BARDAK1995/me407/docs/figures/mid_frame_render.png

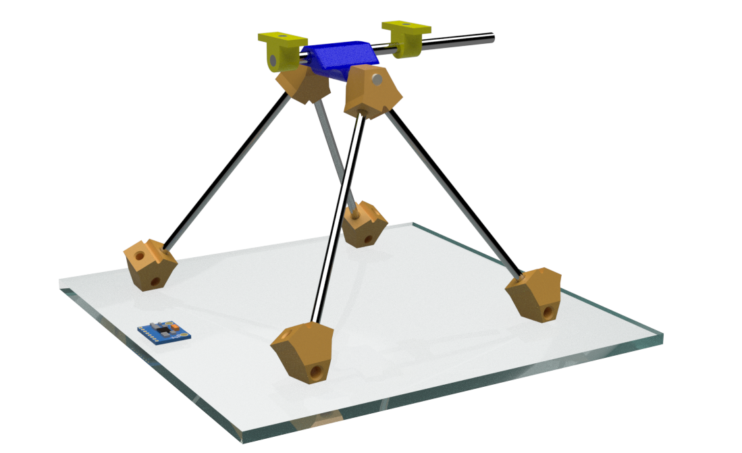
docs/figures/mid_frame_render.png
