BARDAK1995/me407/hardware/BOM.xlsx

Descriptive Part Name | Count | Malzeme Maliyet listesi |  |  |  |  | 3D Printed parts |  |  |  |  | Machined PARTS | operations | machiningTime | unitCost(tl/h) | cost
mpu6050 | 2 | mpu6050 | 2 | 10 | 20 | TL | MPU_ArkaBlokprt x 2 | 2 |  |  |  | tablaCNCfixture | drilling&Milling | 2h | 25 | 50
MPU_ArkaBlokprt x 2 | 2 | 8_digit_7_segment v7 v1_step | 1 | 12 | 12 | TL | mentese | 1 |  |  |  | Tabla | drilling&Milling | 1h | 25 | 25
8_digit_7_segment v7 v1_step | 1 | 4mm_shaft | 1 | 1.666666667 | 1.666666667 | TL | 4mmShaft_fixer x 2 | 2 |  |  |  | plexyBase | drilling&Milling | 0.5h | 25 | 12.5
mentese | 1 | plexyBase | 1 | 18 | 18 | TL | 4mmShaft_fixer_Rev2 x 2 | 2 |  |  |  | plexyBase_alt | drilling | 6min | 25 | 2.5
4mm_shaft | 1 | 4mm_shaft_50mm | 1 | 0.75 | 0.75 | TL | Alt_pim_ADAPTOR | 2 |  |  |  |  |  |  |  | 90
4mmShaft_fixer x 2 | 2 | 4mm_shaft_100mm | 4 | 1.5 | 6 | TL | Alt_pim_ADAPTOR_mirror | 2
4mmShaft_fixer_Rev2 x 2 | 2 | 35mm_cekmePimi | 4 | 1.5 | 6 | TL | yeni_taban_MIRROR | 2
plexyBase | 1 | coupling8_5 | 2 | 11 | 22 | TL | yeni_taban | 2
4mm_shaft_50mm | 1 | TrapexMil | 2 | 20 | 40 | TL | motorShaftHolder | 2
4mm_shaft_100mm | 4 | 4mm_shaft_80mm | 2 | 1.25 | 2.5 | TL | TrapexMilSOMUN | 2
Alt_pim_ADAPTOR | 2 | NEMA_17_STEPPER_34mm | 2 | 65 | 130 | TL | base_Kose_parca | 4
Alt_pim_ADAPTOR_mirror | 2 | plexyBase_Alt | 1 | 10 | 10 | TL | sliderTutucu | 2
35mm_cekmePimi | 4 | pcbKart_8x6 | 2 | 4 | 8 | TL | baglantiMillerArasiUst | 2
yeni_taban_MIRROR | 2 | pcbKart_3x7 | 1 | 3 | 3 | TL | GT2_80Tooth_customPulley | 1
yeni_taban | 2 | pcbKart_2x8 | 1 | 2.5 | 2.5 | TL | nema11_ust_adaptor | 1
motorAssembly | 2 | POS5 MAFSAL | 2 | 10 | 20 | TL
coupling8_5 | 2 | A4988 RED_stepper driver | 3 | 9 | 27 | TL | TOTAL PRINT TIME | 6 | h
TrapexMil | 2 | ATMega328 | 4 | 20 | 80 | TL | COST | 12 | TL
motorShaftHolder | 2 | tabla | 1 | 4 | 4 | TL
4mm_shaft_80mm | 2 | tablaCNCfixture 200x200x30 ahsap | 1 | 20 | 20 | TL
TrapexMilSOMUN | 2 | Shf 8 | 1 | 20 | 20 | TL
NEMA_17_STEPPER_34mm | 2 | 4mm_shaft_USTRAY | 1 | 1.5 | 1.5 | TL
plexyBase_Alt | 1 | 4mm_shaft_110 | 2 | 1.666666667 | 3.333333333 | TL
base_Kose_parca | 3 | GT2_16 Teeth Pulley. | 1 | 10 | 10 | TL
pcbKart_8x6 | 2 | 8MM_ust_MIL | 1 | 3 | 3 | TL
pcbKart_3x7 | 1 | NEMA11_stepper | 1 | 140 | 140 | TL | Tasarim maliyeti
pcbKart_2x8 | 1 | RULMAN_ic_custom | 2 | 10 | 20 | TL | Tanim | iscilik saati | birim maliyet | TOPLAM MALIYET
POS5 MAFSAL | 2 | GT2_200mm_kapaliKayis | 1 | 12 | 12 | TL | Mekanik Tasarim isciligi | 150 | 35 | 5250 | TL
A4988 RED_stepper driver | 3 | Hex Nut, 1A, DIN,M4x0_7 316 | 6 | 0.04 | 0.24 | TL | elektronik&yazilim tasarimi | 100 | 35 | 3500 | TL
ATMega328 | 4 | DISPLAY_SUBBASS | 1 |  | 0 | TL | Testler dizayni calismalari | 5 | 35 | 175 | TL
topAssemblyprt | 1 | Hex Socket C-sunk Head Screw, DIN,M4x16 | 24 | 0.3 | 7.2 | TL | gelistirme testleri | 5 | 35 | 175 | TL
tablaCNCfixture 200x200x30 ahsap |  | Hex Socket Head Cap Screw, AM,M3x0.5x8 | 24 | 0.5 | 12 | TL | teknik resimler | 2 | 35 | 70 | TL
tabla | 1 | Hex Nut, 1A, DIN,M3x0_5 | 29 | 0.36 | 10.44 | TL |  |  |  | 9170 | TL
Shf 8 | 1 | Hex Socket Head Cap Screw, AM,M2.5x0.5x10 | 4 | 2 | 8 | TL | Kalite Maliyeti
sliderTutucu | 2 | 4digit 7 segment display module | 1 | 14 | 14 | TL | Tanim | iscilik saati | birim maliyet | TOPLAM MALIYET
4mm_shaft_USTRAY | 1 | on/OFF switch | 1 | 1.5 | 1.5 | TL | Millerin cap olcumu/fit testleri | 1 | 35 | 35 | TL
baglantiMillerArasiUst | 2 | nrf24l01 | 2 | 8 | 16 | TL | uretilen parcalarin mastarla testi | 1 | 35 | 35 | TL
4mm_shaft_110 | 2 | Arduino Nano | 1 | 24 | 24 | TL | Gereksinim dogrulama testleri | 10 | 35 | 350 | TL
GT2_16 Teeth Pulley. | 1 | 3.7v lithium Battery | 1 | 24 | 24 | TL |  |  |  | 420 | TL
8MM_ust_MIL | 1 | step up convertor | 1 | 6 | 6 | TL | Montaj Isciligi Maliyeti
GT2_80Tooth_customPulley | 1 | Joystick module | 1 | 3 | 3 | TL | Tanim | iscilik saati | birim maliyet | TOPLAM MALIYET
NEMA11_stepper | 1 | 2.1mm DC female Jack | 1 | 2 | 2 | TL | Montaj calismalari | 1 | 35 | 35 | TL
RULMAN_ic_custom | 2 | 3.3v Stepdown regulator | 1 | 2.5 | 2.5 | TL | elektronik kart dizimi | 5 | 35 | 175 | TL
nema11_ust_adaptor | 1 | 5v Stepdown regulator | 1 | 3 | 3 | TL |  |  |  | 210 | TL
GT2_200mm_kapaliKayis | 1 | big fin | 1 | 2 | 2 | TL | Montaj Isciligi Maliyeti
Hex Nut, 1A, DIN,M4x0_7 316 | 6 | small fin | 4 | 1.2 | 4.8 | TL | Tanim | iscilik saati | birim maliyet | TOPLAM MALIYET
DISPLAY_SUBBASS | 1 | 2.2uF elektrolit CAP | 4 | 1.25 | 5 | TL | Montaj calismalari | 1 | 35 | 35 | TL
Hex Socket C-sunk Head Screw, DIN,M4x16 | 24 | 1000UF elektrolit cap | 1 | 0.65 | 0.65 | TL | elektronik kart dizimi | 5 | 35 | 175 | TL
Hex Socket Head Cap Screw, AM,M3x0.5x8 | 24 | 22nf ceramic cap | 8 | 1 | 8 | TL |  |  |  | 210 | TL
Hex Nut, 1A, DIN,M3x0_5 | 29 | 16mgz quarts cristal oscilator | 4 | 1 | 4 | TL | Uretici yatirim maliyetleri
Hex Socket Head Cap Screw, AM,M2.5x0.5x10 | 4 | male header | 35 | 0.1 | 3.5 | TL | CNC |  |  | 1800 | TL
 |  | female header | 150 | 0.1 | 15 | TL | CNC Enclosure/Isolation |  |  | 450 | TL
4digit 7 segment display module | 1 | 2pin cable | 2 | 1 | 2 | TL | CNC milling/Drilling bits |  |  | 350 | TL
on/OFF switch | 1 | 3 pin cable | 2 | 2 | 4 | TL |  |  |  | 2600 | TL
nrf24l01 | 2 | 5pin cable | 4 | 6 | 24 | TL
Arduino Nano | 1 | 12v 1.5amp DC POWER SUPLY | 1 | 15 | 15 | TL
3.7v lithium Battery | 1 | TOTAL COST |  |  | 865.08 | TL
step up convertor | 1
Joystick module | 1
2.1mm DC female Jack | 1
3.3v Stepdown regulator | 1
5v Stepdown regulator | 1
big fin | 1
small fin | 4
2.2uF elektrolit CAP | 4
1000UF elektrolit cap | 1
22nf ceramic cap | 8
16mgz quarts cristal oscilator | 4
male header | 35
female header | 150
2pin cable | 2
3 pin cable | 2
5pin cable | 4
12v 1.5amp DC POWER SUPLY | 1
