BARDAK1995/me407/hardware/cost.xlsx

COST&PROJECT BUDGET
Component costs
Description | ### | Unit Cost | Total Cost
mpu6050 | 2 | 10.0 | 20 | TL
8_digit_7_segment v7 | 1 | 12.0 | 12 | TL
4mm_shaft | 1 | 1.7 | 1.666666667 | TL
plexyBase | 1 | 15.0 | 15 | TL
4mm_shaft_50mm | 1 | 0.8 | 0.75 | TL
4mm_shaft_100mm | 4 | 1.5 | 6 | TL
35mm_cekmePimi | 4 | 1.5 | 6 | TL | Tasarim maliyeti
coupling8_5 | 2 | 11.0 | 22 | TL | Tanim | iscilik saati | birim maliyet | TOPLAM MALIYET
TrapexMil | 2 | 20.0 | 40 | TL | Mekanik Tasarim isciligi | 150 | 35 | 5250 | TL
4mm_shaft_80mm | 2 | 1.2 | 2.5 | TL | elektronik&yazilim tasarimi | 100 | 35 | 3500 | TL
NEMA_17_STEPPER_34mm | 2 | 65.0 | 130 | TL | Testler dizayni calismalari | 5 | 35 | 175 | TL
plexyBase_Alt | 1 | 10.0 | 10 | TL | gelistirme testleri | 5 | 35 | 175 | TL
pcbKart_8x6 | 2 | 4.0 | 8 | TL | teknik resimler | 2 | 35 | 70 | TL
pcbKart_3x7 | 1 | 3.0 | 3 | TL |  |  |  | 9170 | TL
pcbKart_2x8 | 1 | 2.5 | 2.5 | TL | Kalite Maliyeti
POS5 MAFSAL | 2 | 10.0 | 20 | TL | Tanim | iscilik saati | birim maliyet | TOPLAM MALIYET
A4988 RED_stepper driver | 3 | 9.0 | 27 | TL | Millerin cap olcumu/fit testleri | 1 | 35 | 35 | TL
ATMega328 | 4 | 20.0 | 80 | TL | uretilen parcalarin mastarla testi | 1 | 35 | 35 | TL
tabla | 1 | 4.0 | 4 | TL | Gereksinim dogrulama testleri | 10 | 35 | 350 | TL
tablaCNCfixture 200x200x30 ahsap | 1 | 20.0 | 20 | TL |  |  |  | 420 | TL
Shf 8 | 1 | 20.0 | 20 | TL | Montaj Isciligi Maliyeti
4mm_shaft_USTRAY | 1 | 1.5 | 1.5 | TL | Tanim | iscilik saati | birim maliyet | TOPLAM MALIYET
4mm_shaft_110 | 2 | 1.7 | 3.333333333 | TL | Montaj calismalari | 1 | 35 | 35 | TL
GT2_16 Teeth Pulley. | 1 | 10.0 | 10 | TL | elektronik kart dizimi | 5 | 35 | 175 | TL
8MM_ust_MIL | 1 | 3.0 | 3 | TL |  |  |  | 210 | TL
NEMA11_stepper | 1 | 140.0 | 140 | TL | Montaj Isciligi Maliyeti
RULMAN_ic_custom | 2 | 10.0 | 20 | TL | Tanim | iscilik saati | birim maliyet | TOPLAM MALIYET
GT2_200mm_kapaliKayis | 1 | 12.0 | 12 | TL | Montaj calismalari | 1 | 35 | 35 | TL
Hex Nut, 1A, DIN,M4x0_7 316 | 6 | 0.04 | 0.24 | TL | elektronik kart dizimi | 5 | 35 | 175 | TL
DISPLAY_SUBBASS | 1 |  | 0 | TL |  |  |  | 210 | TL
Hex Socket C-sunk Head Screw, DIN,M4x16 | 24 | 0.3 | 7.2 | TL | Uretici yatirim maliyetleri
Hex Socket Head Cap Screw, AM,M3x0.5x8 | 24 | 0.5 | 12 | TL | CNC |  |  | 1800 | TL
Hex Nut, 1A, DIN,M3x0_5 | 29 | 0.4 | 10.44 | TL | CNC Enclosure/Isolation |  |  | 450 | TL
Hex Socket Head Cap Screw, AM,M2.5x0.5x10 | 4 | 2.0 | 8 | TL | CNC milling/Drilling bits |  |  | 350 | TL
4digit 7 segment display module | 1 | 14.0 | 14 | TL |  |  |  | 2600 | TL
on/OFF switch | 1 | 1.5 | 1.5 | TL
nrf24l01 | 2 | 8.0 | 16 | TL
Arduino Nano | 1 | 24.0 | 24 | TL
3.7v lithium Battery | 1 | 24.0 | 24 | TL
step up convertor | 1 | 6.0 | 6 | TL
Joystick module | 1 | 3.0 | 3 | TL
2.1mm DC female Jack | 1 | 2.0 | 2 | TL
3.3v Stepdown regulator | 1 | 2.5 | 2.5 | TL
5v Stepdown regulator | 1 | 3.0 | 3 | TL
big fin | 1 | 2.0 | 2 | TL
small fin | 4 | 1.2 | 4.8 | TL
2.2uF elektrolit CAP | 4 | 1.2 | 5 | TL
1000UF elektrolit cap | 1 | 0.7 | 0.65 | TL
22nf ceramic cap | 8 | 1.0 | 8 | TL
16mgz quarts cristal oscilator | 4 | 1.0 | 4 | TL
male header | 35 | 0.1 | 3.5 | TL
female header | 150 | 0.1 | 15 | TL
2pin cable | 2 | 1.0 | 2 | TL
3 pin cable | 2 | 2.0 | 4 | TL
5pin cable | 4 | 6.0 | 24 | TL
12v 1.5amp DC POWER SUPLY | 1 | 15.0 | 15 | TL
TOTAL COST |  |  | 862.08 | TL
3D Printed parts
Part Name |  |  | # of items
MPU_ArkaBlokprt x 2 |  |  | 2
mentese |  |  | 1
4mmShaft_fixer x 2 |  |  | 2
4mmShaft_fixer_Rev2 x 2 |  |  | 2
Alt_pim_ADAPTOR |  |  | 2
Alt_pim_ADAPTOR_mirror |  |  | 2
yeni_taban_MIRROR |  |  | 2
yeni_taban |  |  | 2
motorShaftHolder |  |  | 2
TrapexMilSOMUN |  |  | 2
base_Kose_parca |  |  | 4
sliderTutucu |  |  | 2
baglantiMillerArasiUst |  |  | 2
GT2_80Tooth_customPulley |  |  | 1
nema11_ust_adaptor |  |  | 1
TOTAL PRINT TIME |  |  | 6 | h
TOTAL COST |  |  | 12 | TL
MACHINED PARTS
Part Name | operations | machiningTime | unitCost(tl/h) | cost
tablaCNCfixture | drilling&Milling | 2h | 25 | 50
Tabla | drilling&Milling | 1h | 25 | 25
plexyBase | drilling&Milling | 0.5h | 25 | 12.5
plexyBase_alt | drilling | 6min | 25 | 2.5
TOTAL COST |  |  | 90 | TL
Design&development Costs
Description | man hours | Cost/time | TOTAL COST
mechanical design | 150 | 35 | 5250 | TL
Electronics&software design | 100 | 35 | 3500 | TL
Test design | 5 | 35 | 175 | TL
Project development tests | 5 | 35 | 175 | TL
Technical drawings | 2 | 35 | 70 | TL
TOTAL COST |  |  | 9170 | TL
quality management costs
Description | man hours | Cost/time | TOTAL COST
dimensional testing of the parts&fits | 1 | 35 | 35 | TL
Qualification tests | 10 | 35 | 350 | TL
TOTAL COST |  |  | 385 | TL
Assembly Costs
Description | man hours | Cost/time | TOTAL COST
Mechanical assembly | 1 | 35 | 35 | TL
Circuit Soldering&testing | 5 | 35 | 175 | TL
TOTAL COST |  |  | 210 | TL
Manufacturer investment costs
CNC router build+mods |  |  | 2000 | TL
CNC Enclosure/Isolation |  |  | 350 | TL
CNC milling/Drilling bits |  |  | 350 | TL
SOLDERING STATION&HEAT GUN |  |  | 800 | TL
TOTAL COST |  |  | 3500 | TL
Total cost without Labor |  |  | 4374.08 | TL
TOTAL Labor Cost |  |  | 9855 | TL
TOTAL COST |  |  | 14229.08 | TL
