BARDAK1995/me407/hardware/step/8MM_ust_MIL.stp

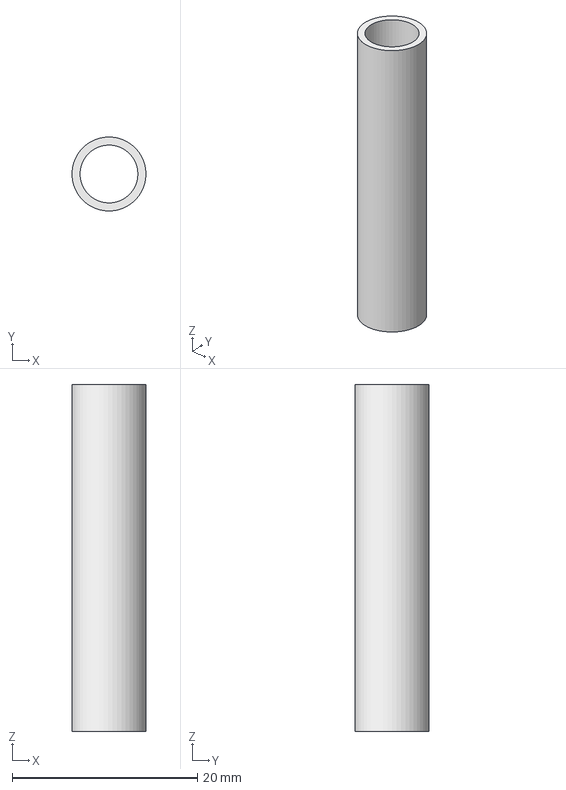
[picture p11: CAD file, 2026-10-28]
hardware/step/8MM_ust_MIL.stp
7.99 x 8.00 x 37.5 mm
