BARDAK1995/me407/hardware/step/4mm_shaft_110.stp

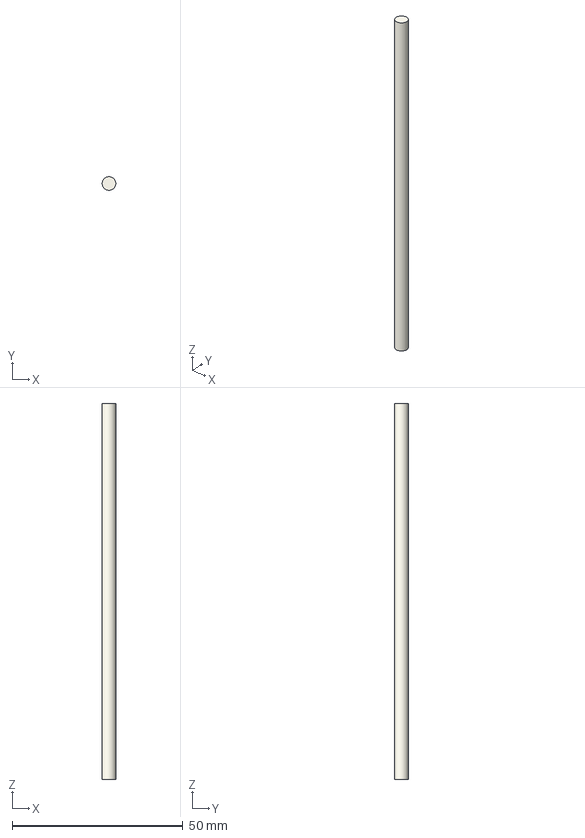
[picture p12: CAD file, 2026-10-28]
hardware/step/4mm_shaft_110.stp
4.00 x 4.00 x 110.0 mm
