BARDAK1995/me407/hardware/step/4mmShaft_fixer_Rev2.stp

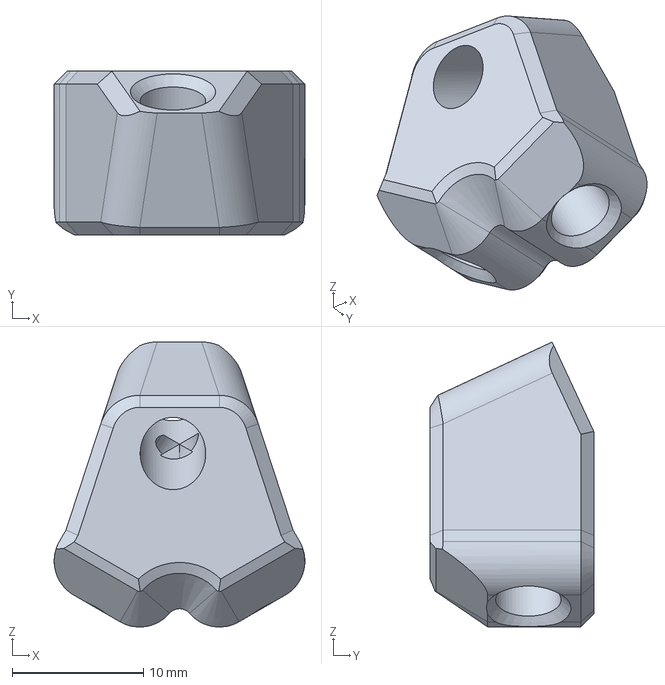
[picture p13: CAD file, 2026-10-28]
hardware/step/4mmShaft_fixer_Rev2.stp
19.1 x 12.5 x 21.7 mm
