BARDAK1995/me407/hardware/step/4mm_shaft_2.stp

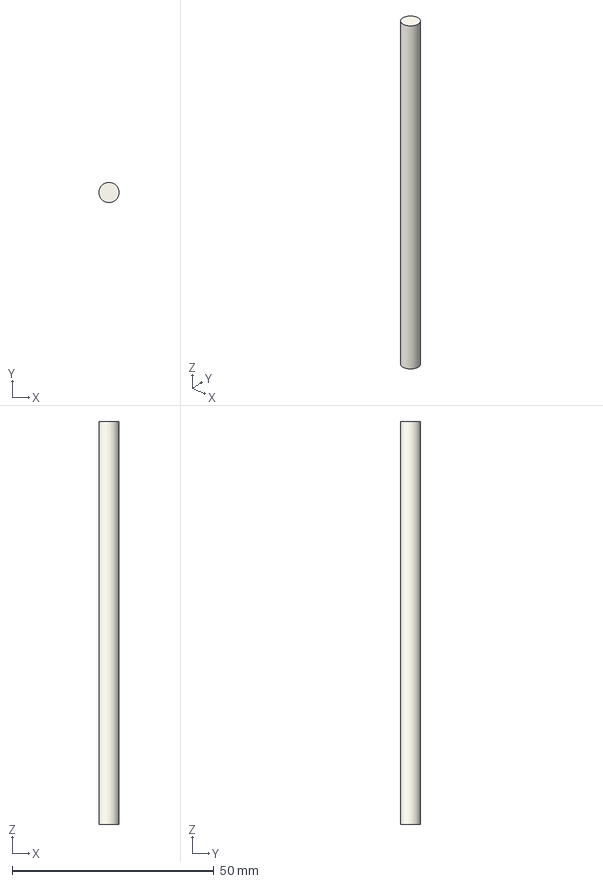
[picture p14: CAD file, 2026-10-28]
hardware/step/4mm_shaft_2.stp
5.00 x 5.00 x 100.0 mm
