BARDAK1995/me407/hardware/step/tabla.stp

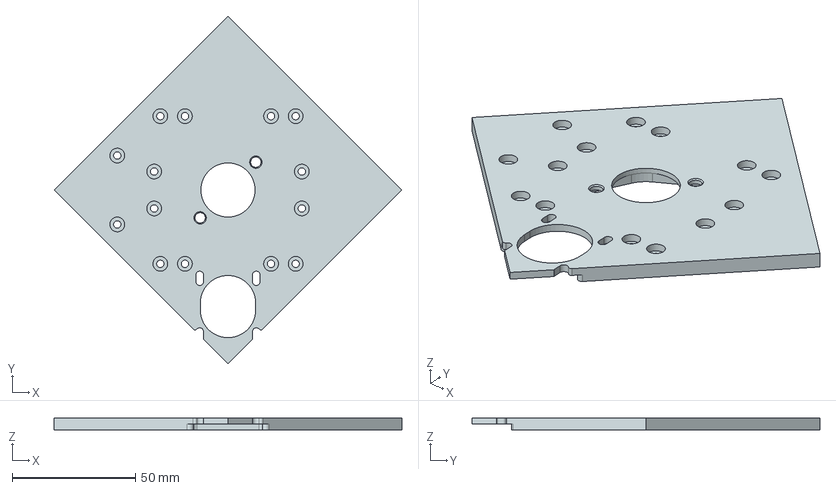
[picture p15: CAD file, 2026-10-28]
hardware/step/tabla.stp
141.4 x 141.4 x 5.00 mm
