BARDAK1995/me407/hardware/step/yeni_taban.stp

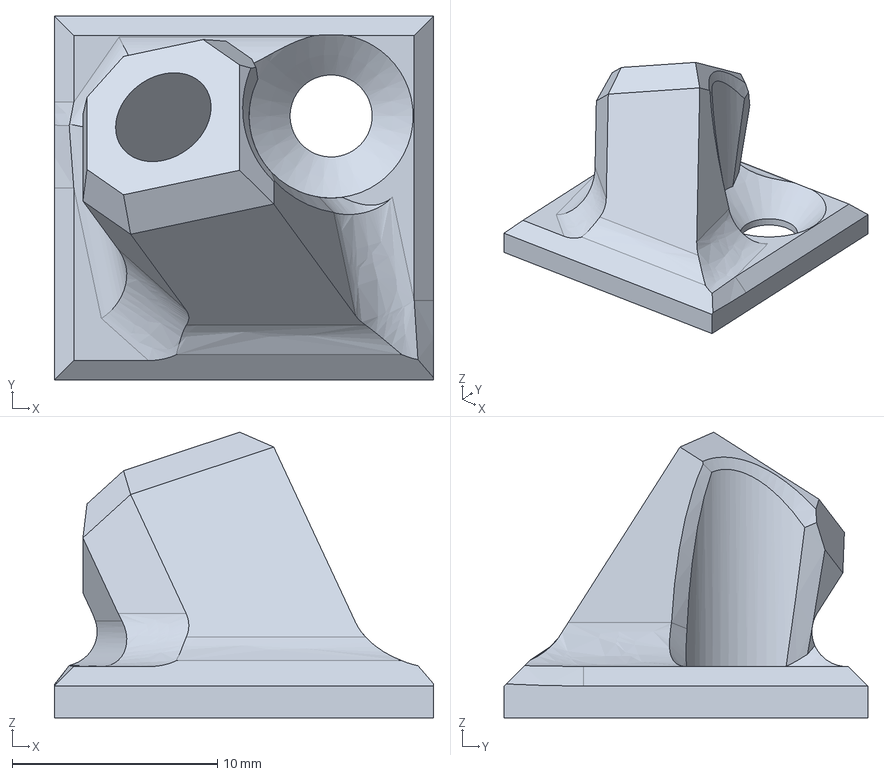
[picture p16: CAD file, 2026-10-28]
hardware/step/yeni_taban.stp
18.5 x 17.8 x 13.9 mm
