BARDAK1995/me407/hardware/step/MPU_ArkaBlokprt.stp

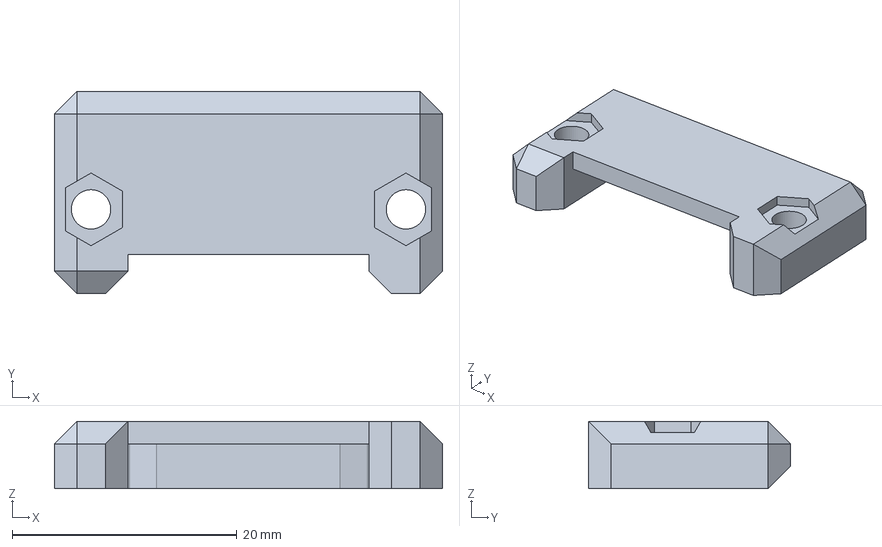
[picture p17: CAD file, 2026-10-28]
hardware/step/MPU_ArkaBlokprt.stp
34.5 x 18.0 x 6.00 mm
