BARDAK1995/me407/hardware/step/Alt_pim_ADAPTOR.stp

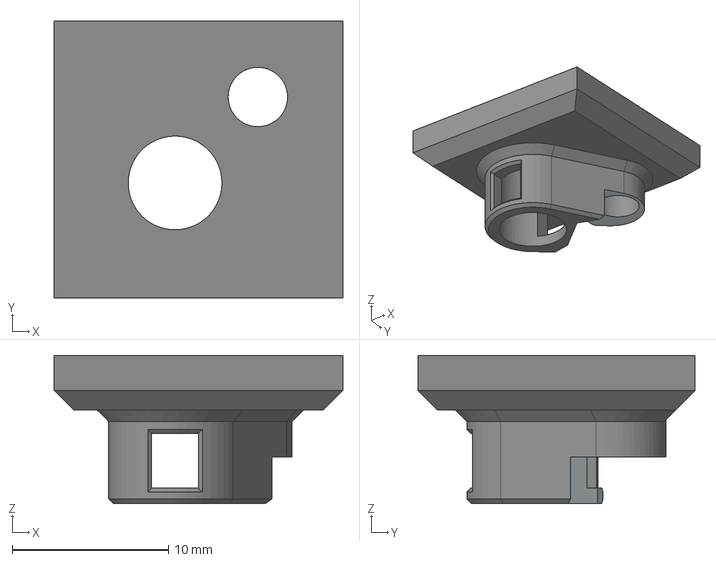
[picture p18: CAD file, 2026-10-28]
hardware/step/Alt_pim_ADAPTOR.stp
18.5 x 17.8 x 9.50 mm
