BARDAK1995/me407/hardware/step/35mm_cekmePimi.stp

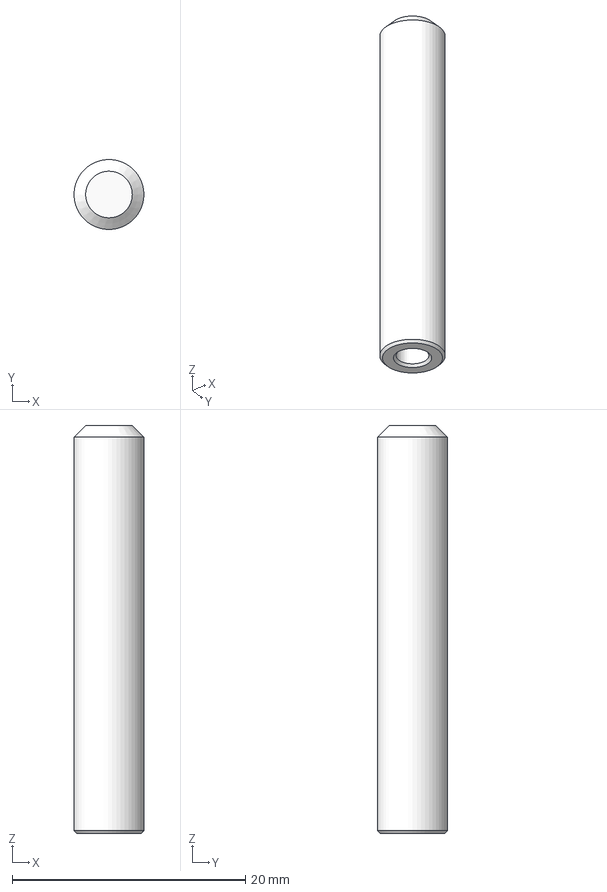
[picture p19: CAD file, 2026-10-28]
hardware/step/35mm_cekmePimi.stp
5.99 x 6.00 x 35.0 mm
