BARDAK1995/me407/hardware/step/sliderTutucu.stp

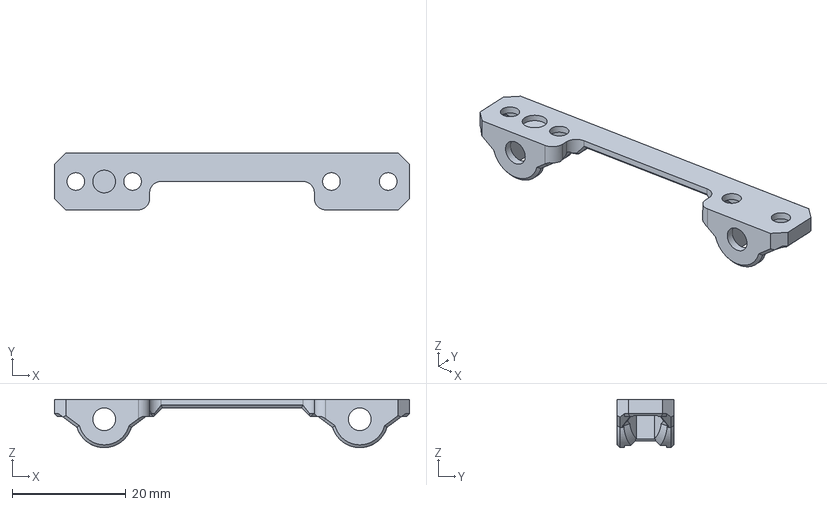
[picture p20: CAD file, 2026-10-28]
hardware/step/sliderTutucu.stp
62.5 x 10.0 x 8.49 mm
