BARDAK1995/me407/hardware/step/baglantiMillerArasiUst.stp

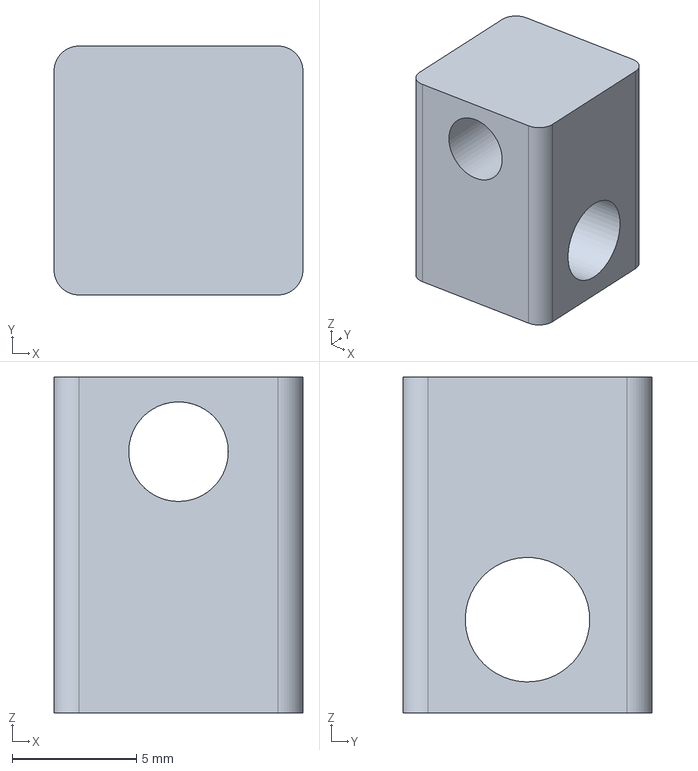
[picture p21: CAD file, 2026-10-28]
hardware/step/baglantiMillerArasiUst.stp
10.0 x 10.0 x 13.5 mm
