BARDAK1995/me407/hardware/step/POS5Holder.stp

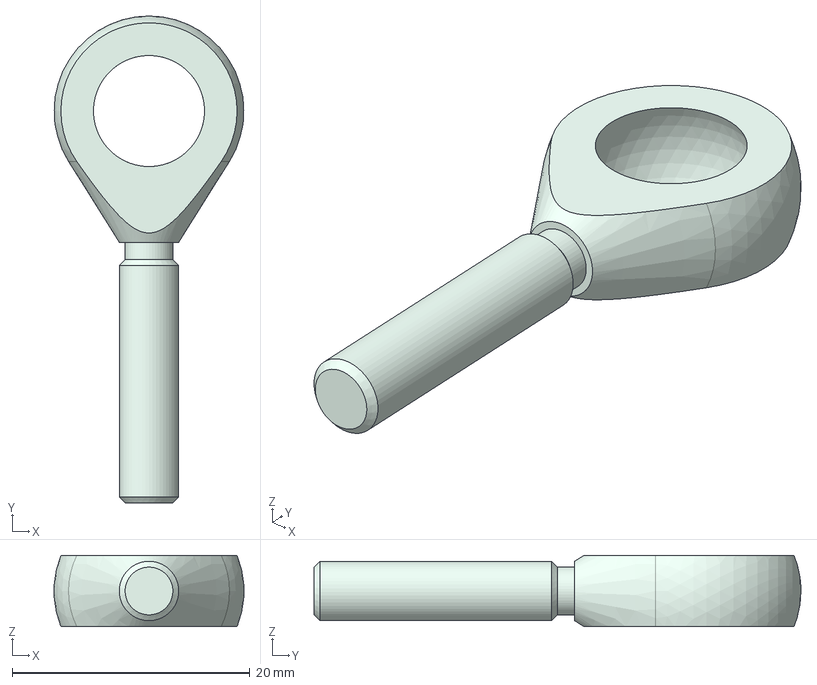
[picture p22: CAD file, 2026-10-28]
hardware/step/POS5Holder.stp
16.0 x 41.0 x 6.00 mm
