BARDAK1995/me407/hardware/step/motorShaftHolder.stp

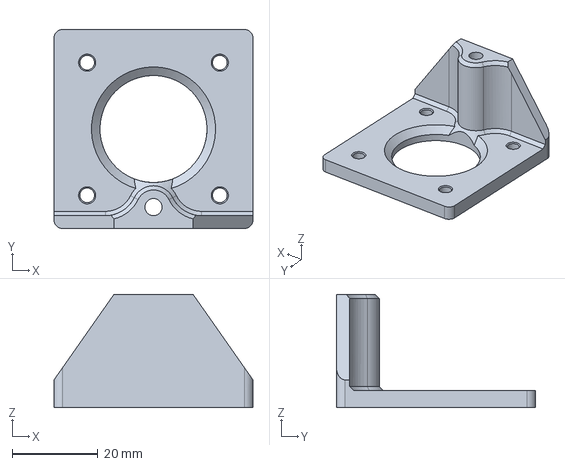
[picture p23: CAD file, 2026-10-28]
hardware/step/motorShaftHolder.stp
46.5 x 46.5 x 26.5 mm
