BARDAK1995/me407/hardware/step/Alt_pim_ADAPTOR_mirror2.stp

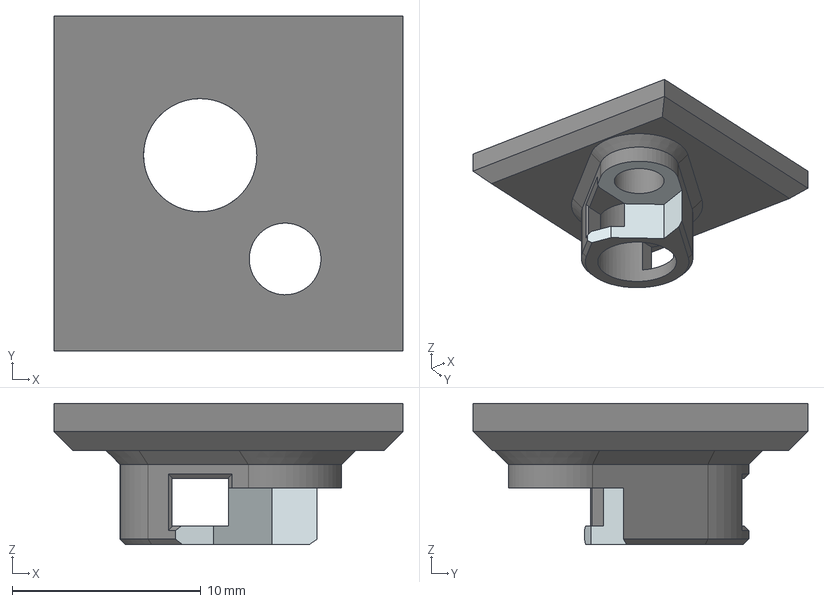
[picture p24: CAD file, 2026-10-28]
hardware/step/Alt_pim_ADAPTOR_mirror2.stp
18.5 x 17.8 x 7.50 mm
