BARDAK1995/me407/hardware/step/mentese.stp

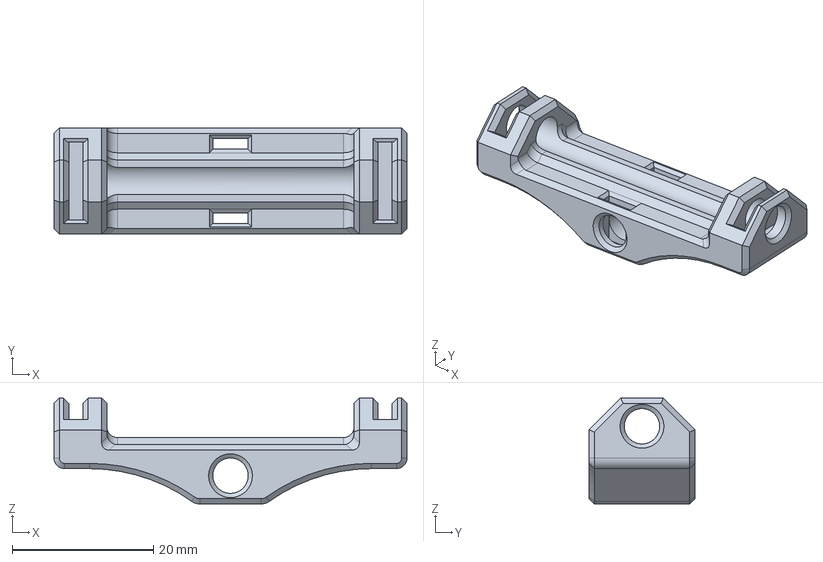
[picture p25: CAD file, 2026-10-28]
hardware/step/mentese.stp
50.0 x 15.0 x 15.0 mm
