BARDAK1995/me407/hardware/step/200Kayis.stp

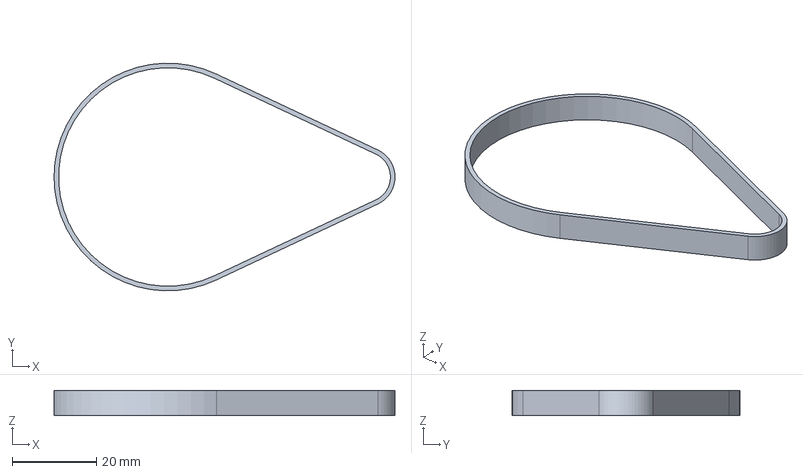
[picture p26: CAD file, 2026-10-28]
hardware/step/200Kayis.stp
81.2 x 54.2 x 6.00 mm
