BARDAK1995/me407/hardware/step/fan_adaptor.stp

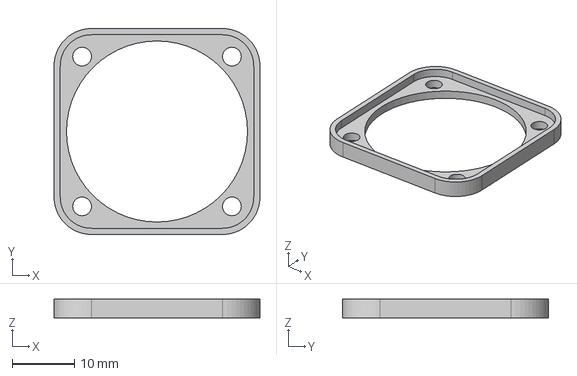
[picture p27: CAD file, 2026-10-28]
hardware/step/fan_adaptor.stp
33.0 x 33.0 x 3.00 mm
