BARDAK1995/me407/hardware/step/plexyBase_Alt.stp

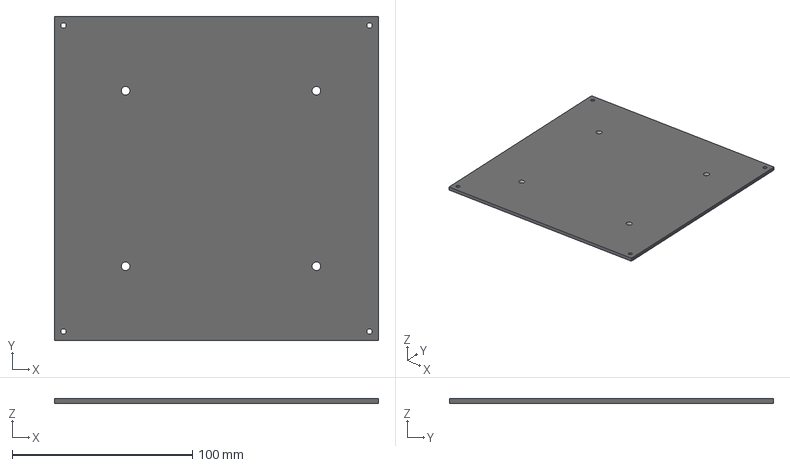
[picture p28: CAD file, 2026-10-28]
hardware/step/plexyBase_Alt.stp
180.0 x 180.0 x 2.70 mm
