BARDAK1995/me407/hardware/step/4mm_shaft_USTRAY.stp

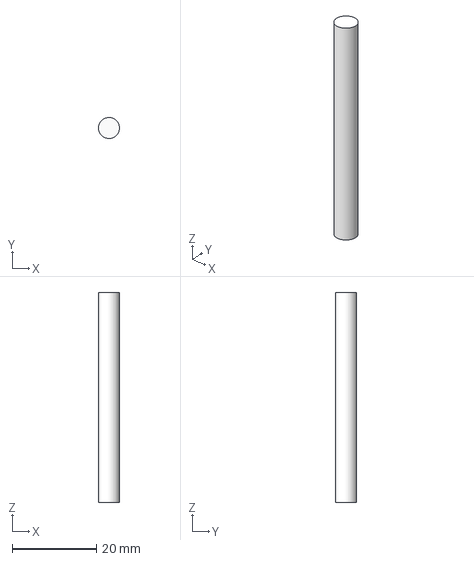
[picture p29: CAD file, 2026-10-28]
hardware/step/4mm_shaft_USTRAY.stp
5.00 x 5.00 x 50.0 mm
