BARDAK1995/me407/hardware/step/POS5Spherical_inner_ring.stp

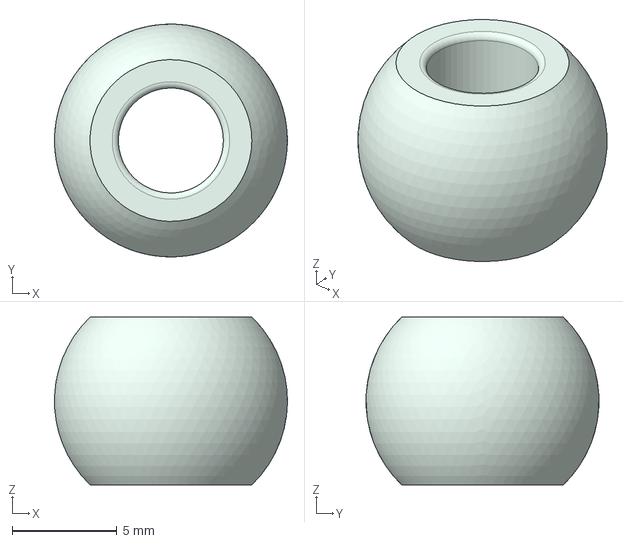
[picture p30: CAD file, 2026-10-28]
hardware/step/POS5Spherical_inner_ring.stp
11.1 x 11.1 x 8.00 mm
