BARDAK1995/me407/hardware/step/RULMAN_ic_custom.stp

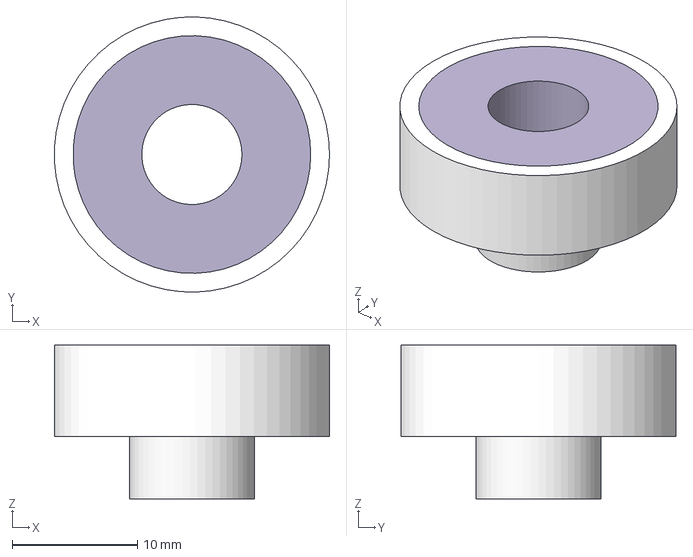
[picture p31: CAD file, 2026-10-28]
hardware/step/RULMAN_ic_custom.stp
22.0 x 22.0 x 12.3 mm
