BARDAK1995/me407/hardware/step/nema11_ust_adaptor.stp

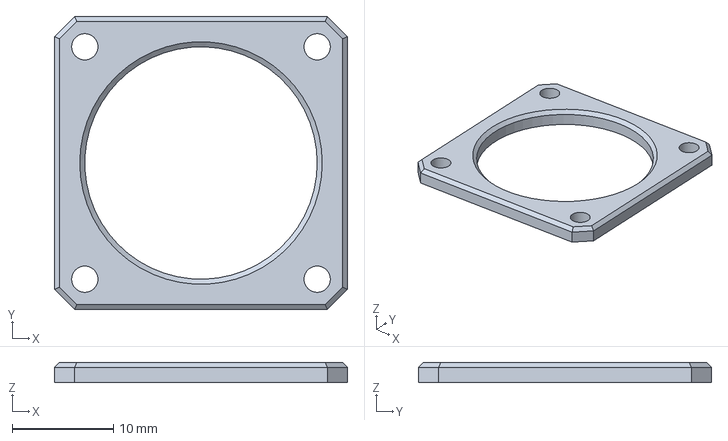
[picture p32: CAD file, 2026-10-28]
hardware/step/nema11_ust_adaptor.stp
29.0 x 29.0 x 2.00 mm
