BARDAK1995/me407/hardware/step/plexyBase.stp

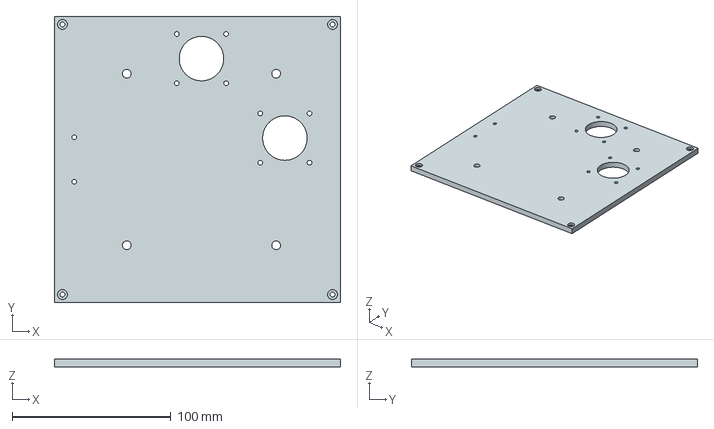
[picture p33: CAD file, 2026-10-28]
hardware/step/plexyBase.stp
180.0 x 180.0 x 5.00 mm
