BARDAK1995/me407/hardware/step/base_Kose_parca.stp

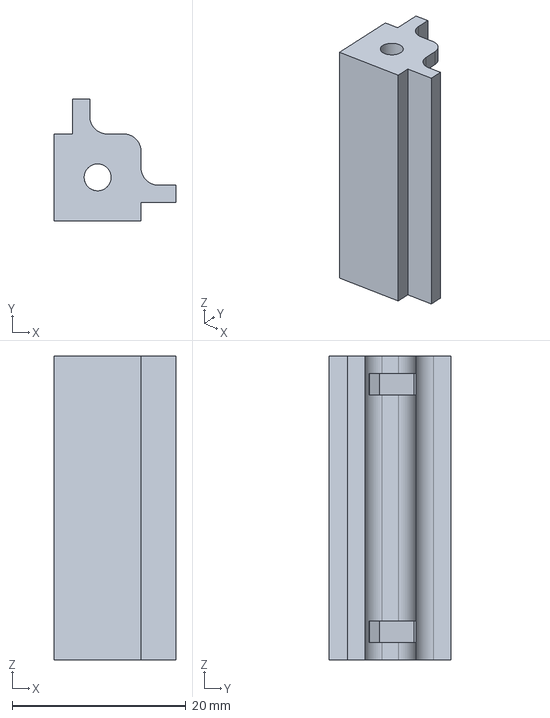
[picture p34: CAD file, 2026-10-28]
hardware/step/base_Kose_parca.stp
14.0 x 14.0 x 35.0 mm
