BARDAK1995/me407/hardware/step/4mmShaft_fixer.stp

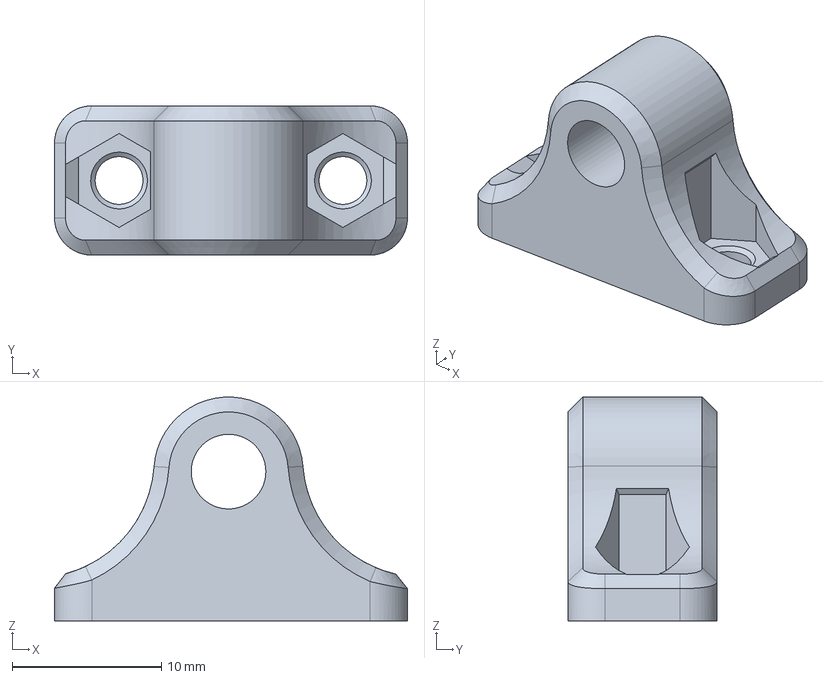
[picture p35: CAD file, 2026-10-28]
hardware/step/4mmShaft_fixer.stp
23.6 x 10.0 x 15.0 mm
