BARDAK1995/me407/(list of files, cad)

Other CAD files:
hardware/step/MASTER_ASSEMBLY.stp
hardware/step/topAssemblyprt.stp
hardware/step/motorAssembly.stp
hardware/step/4mm_shaft.stp
hardware/step/midFrame_SubASS.stp
hardware/step/DISPLAY_SUBBASS.stp
hardware/step/Plywood_BASE.stp
hardware/step/yeni_taban_MIRROR3.stp
