BARDAK1995/me407/hardware/drawings/mert_4mm_shaft_110.pdf

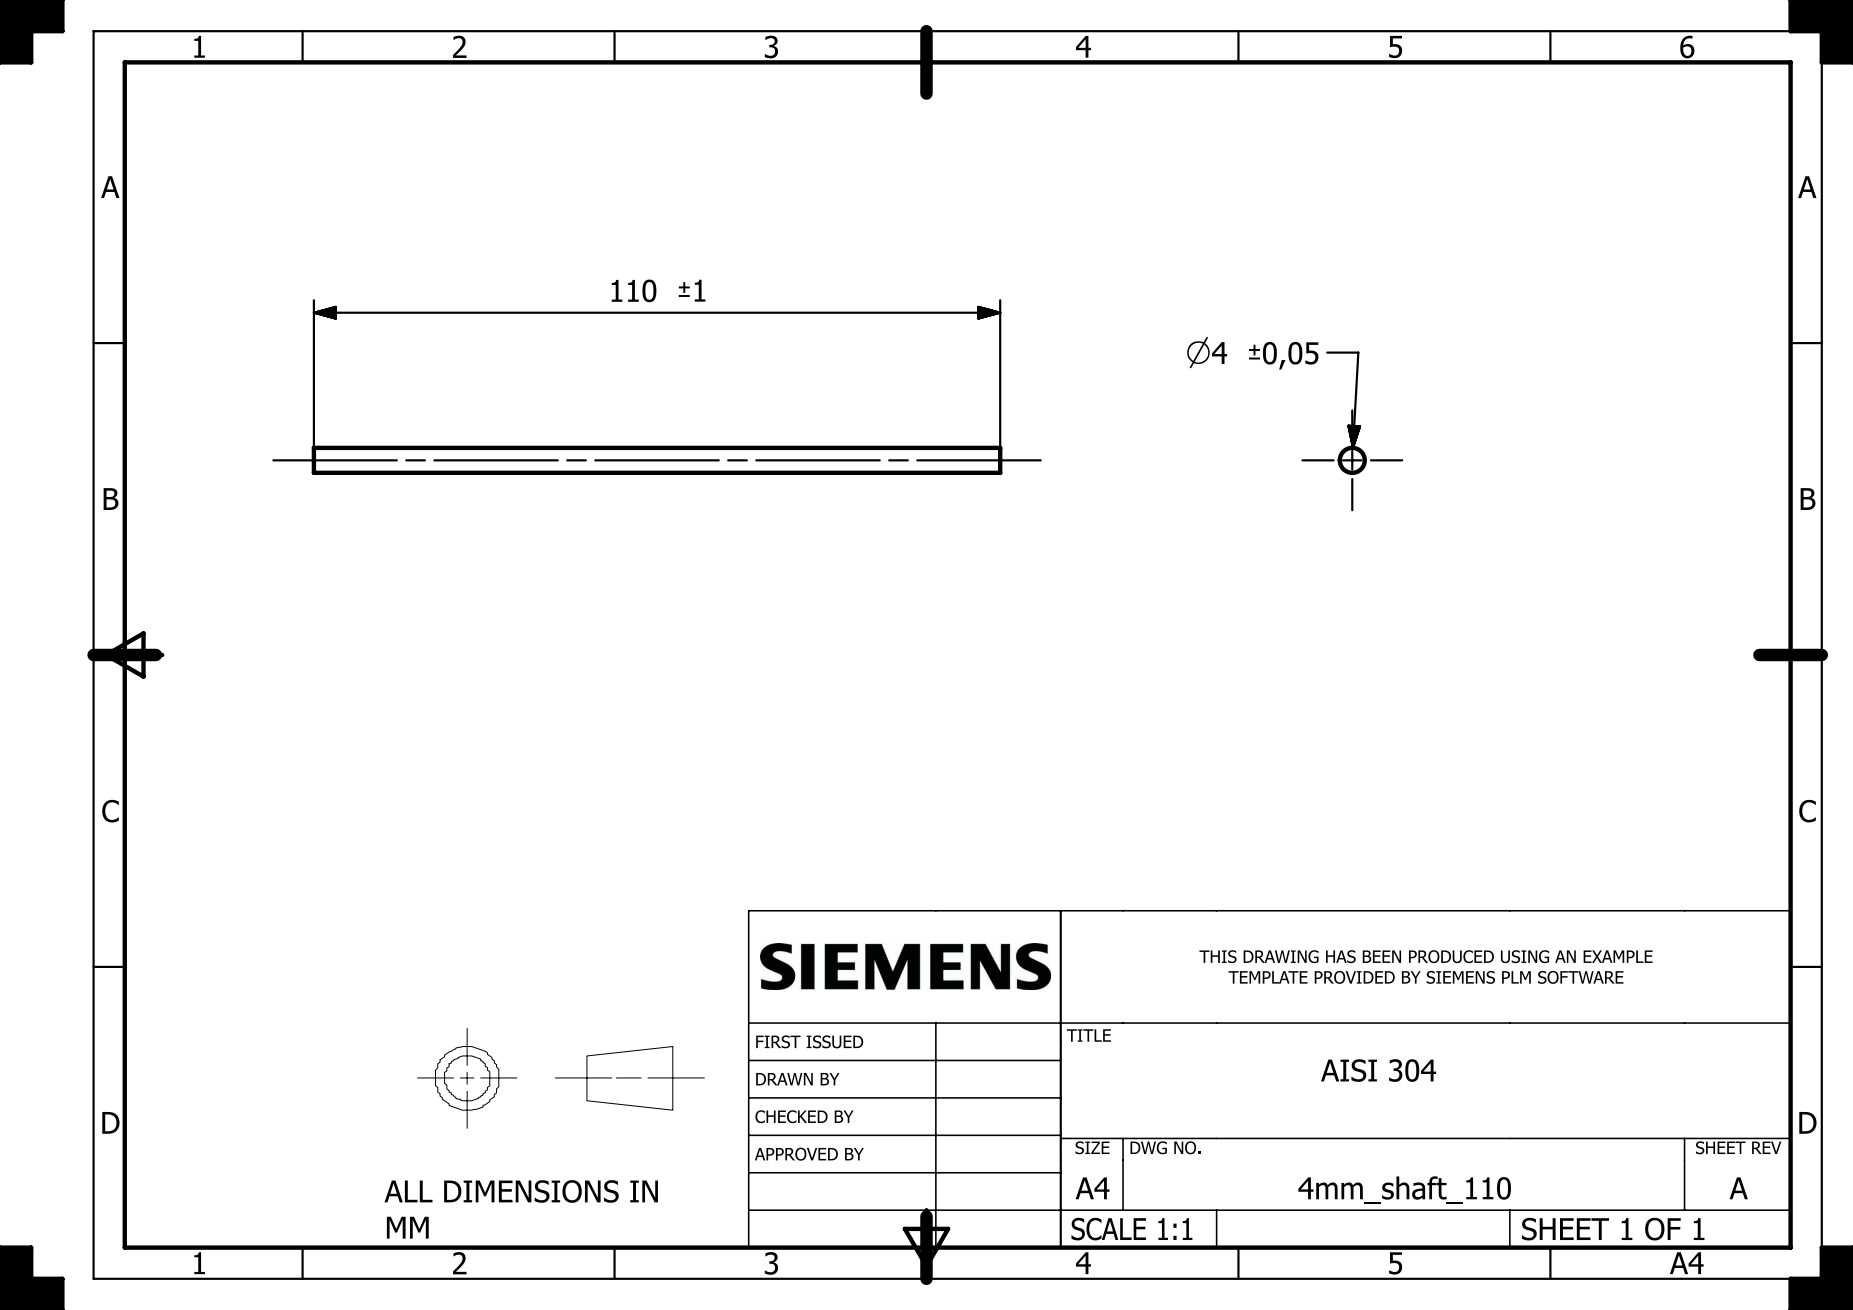
[picture p36: page 1]
