BARDAK1995/me407/hardware/drawings/mert_4mm_shaft_2.pdf

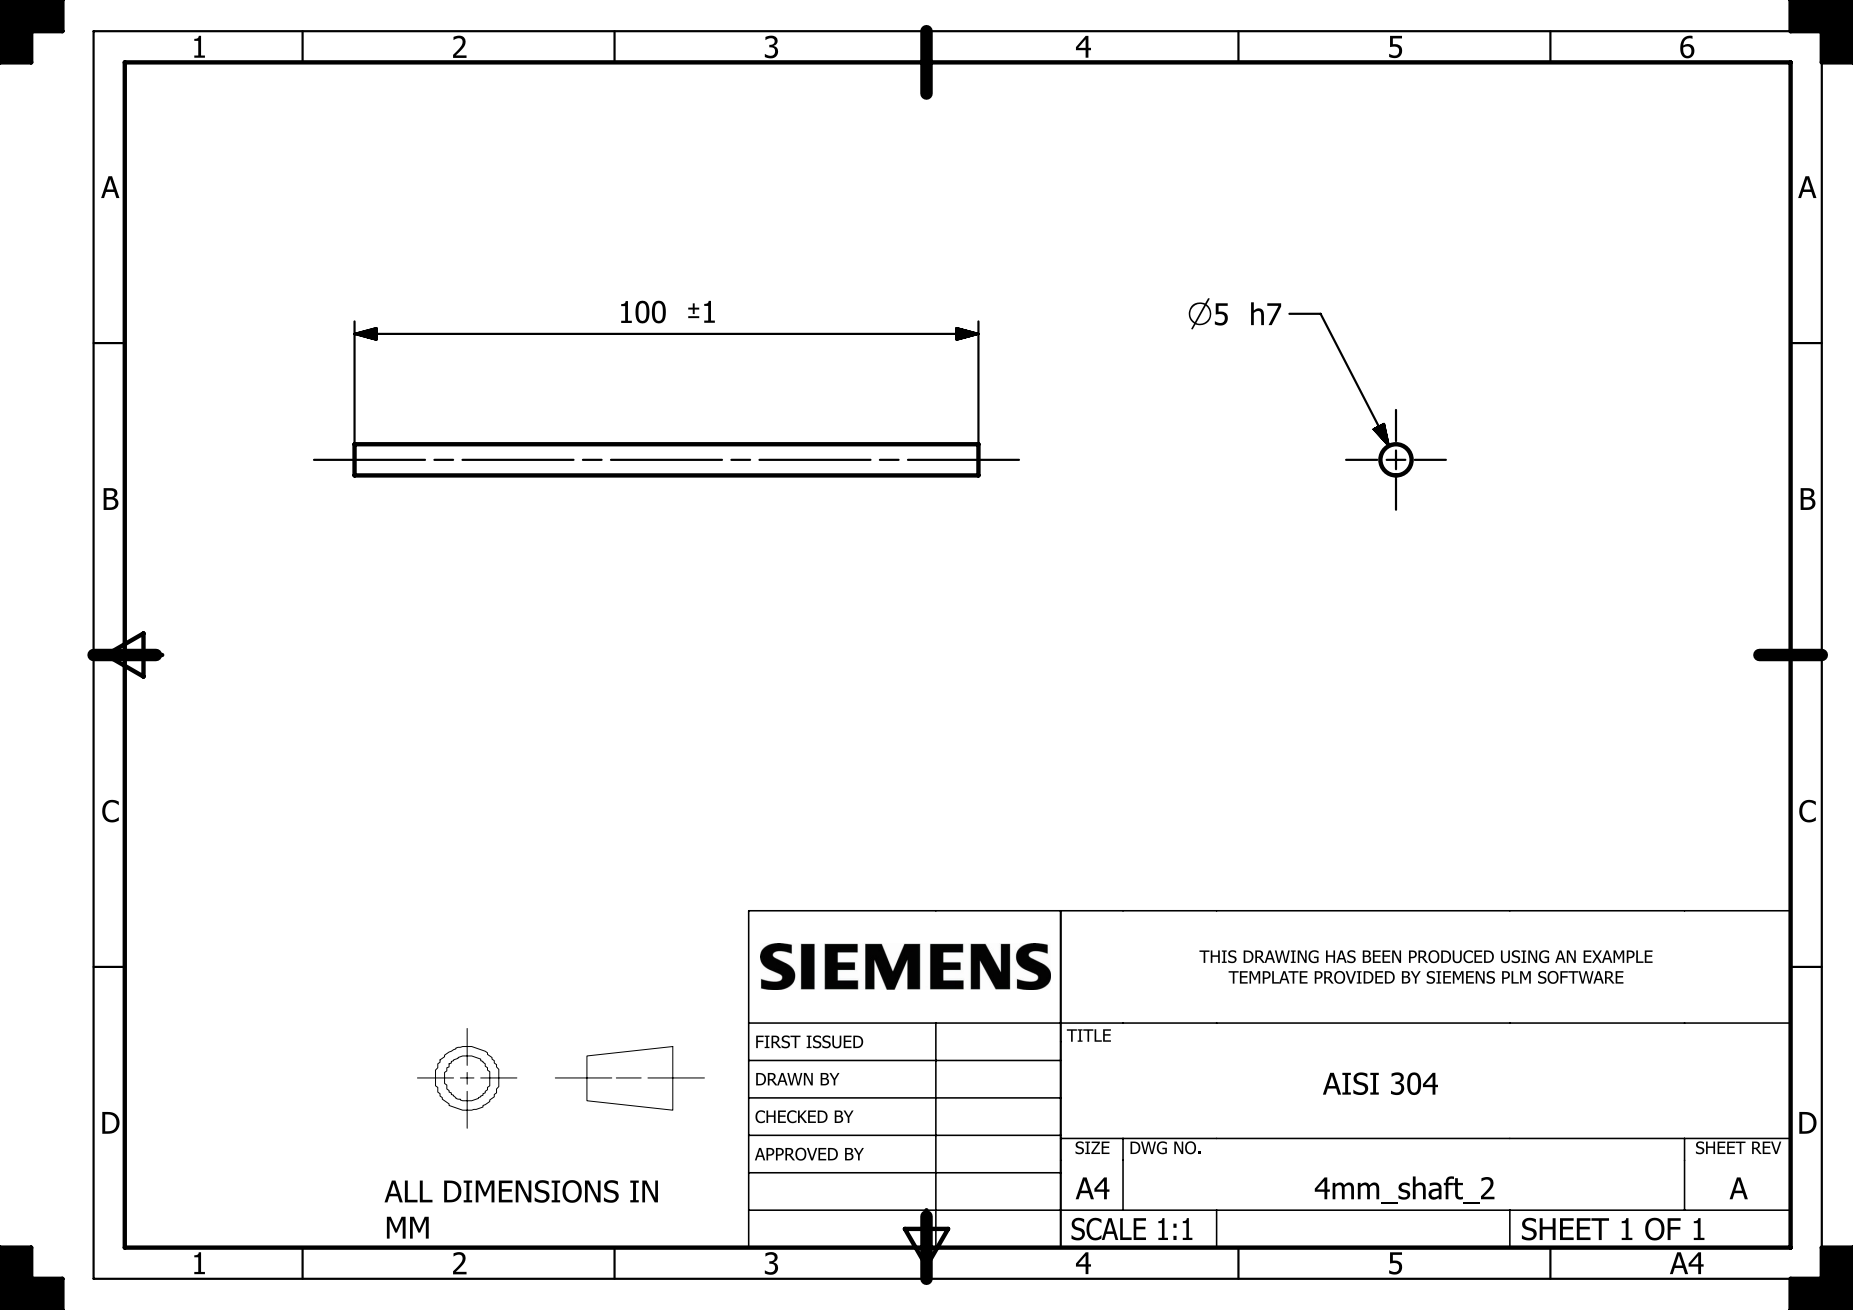
[picture p37: page 1]
