BARDAK1995/me407/hardware/drawings/mert_8MM_ust_Boru.pdf

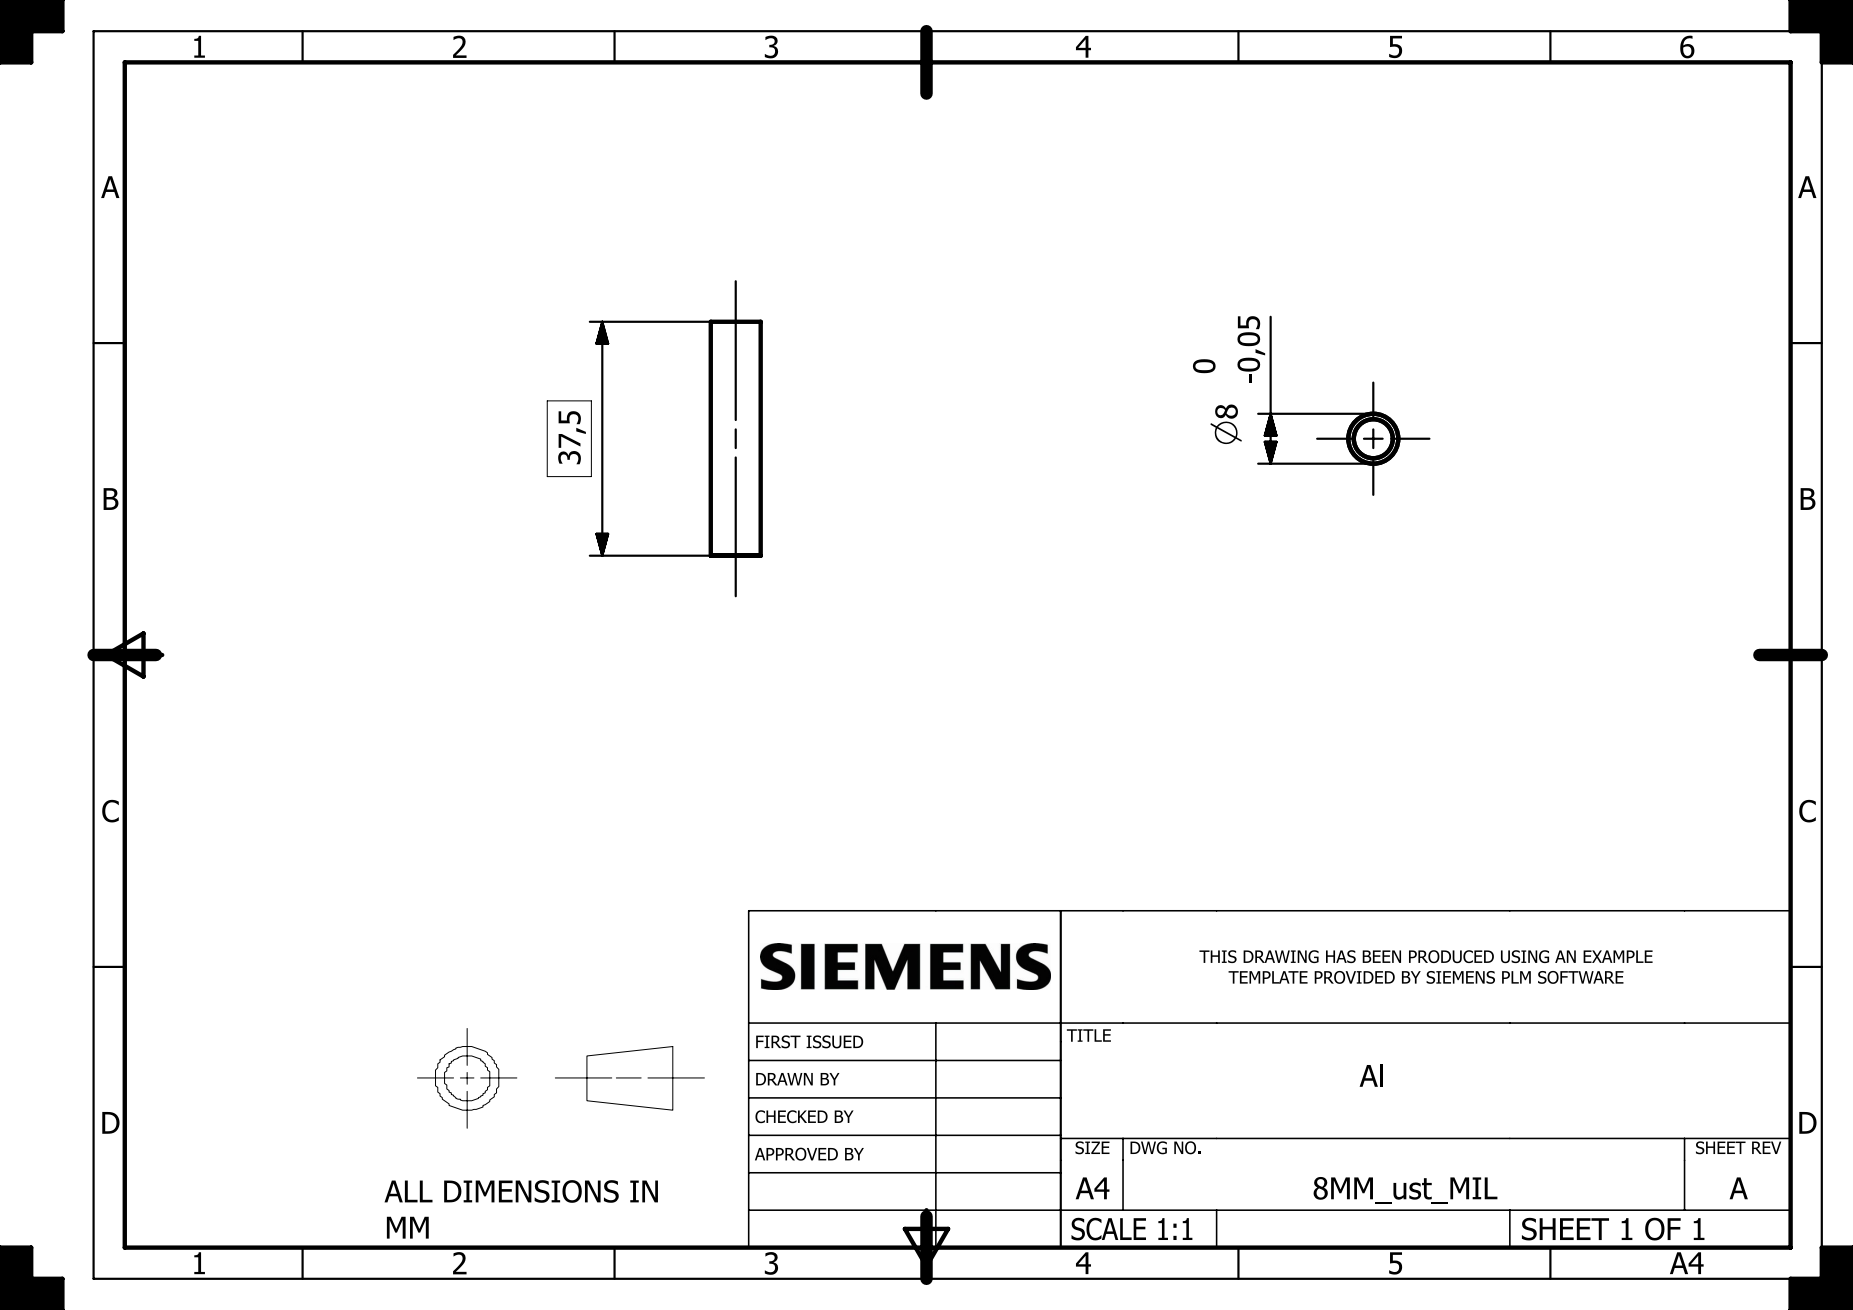
[picture p38: page 1]
