BARDAK1995/me407/hardware/drawings/mert_plexyBase.pdf

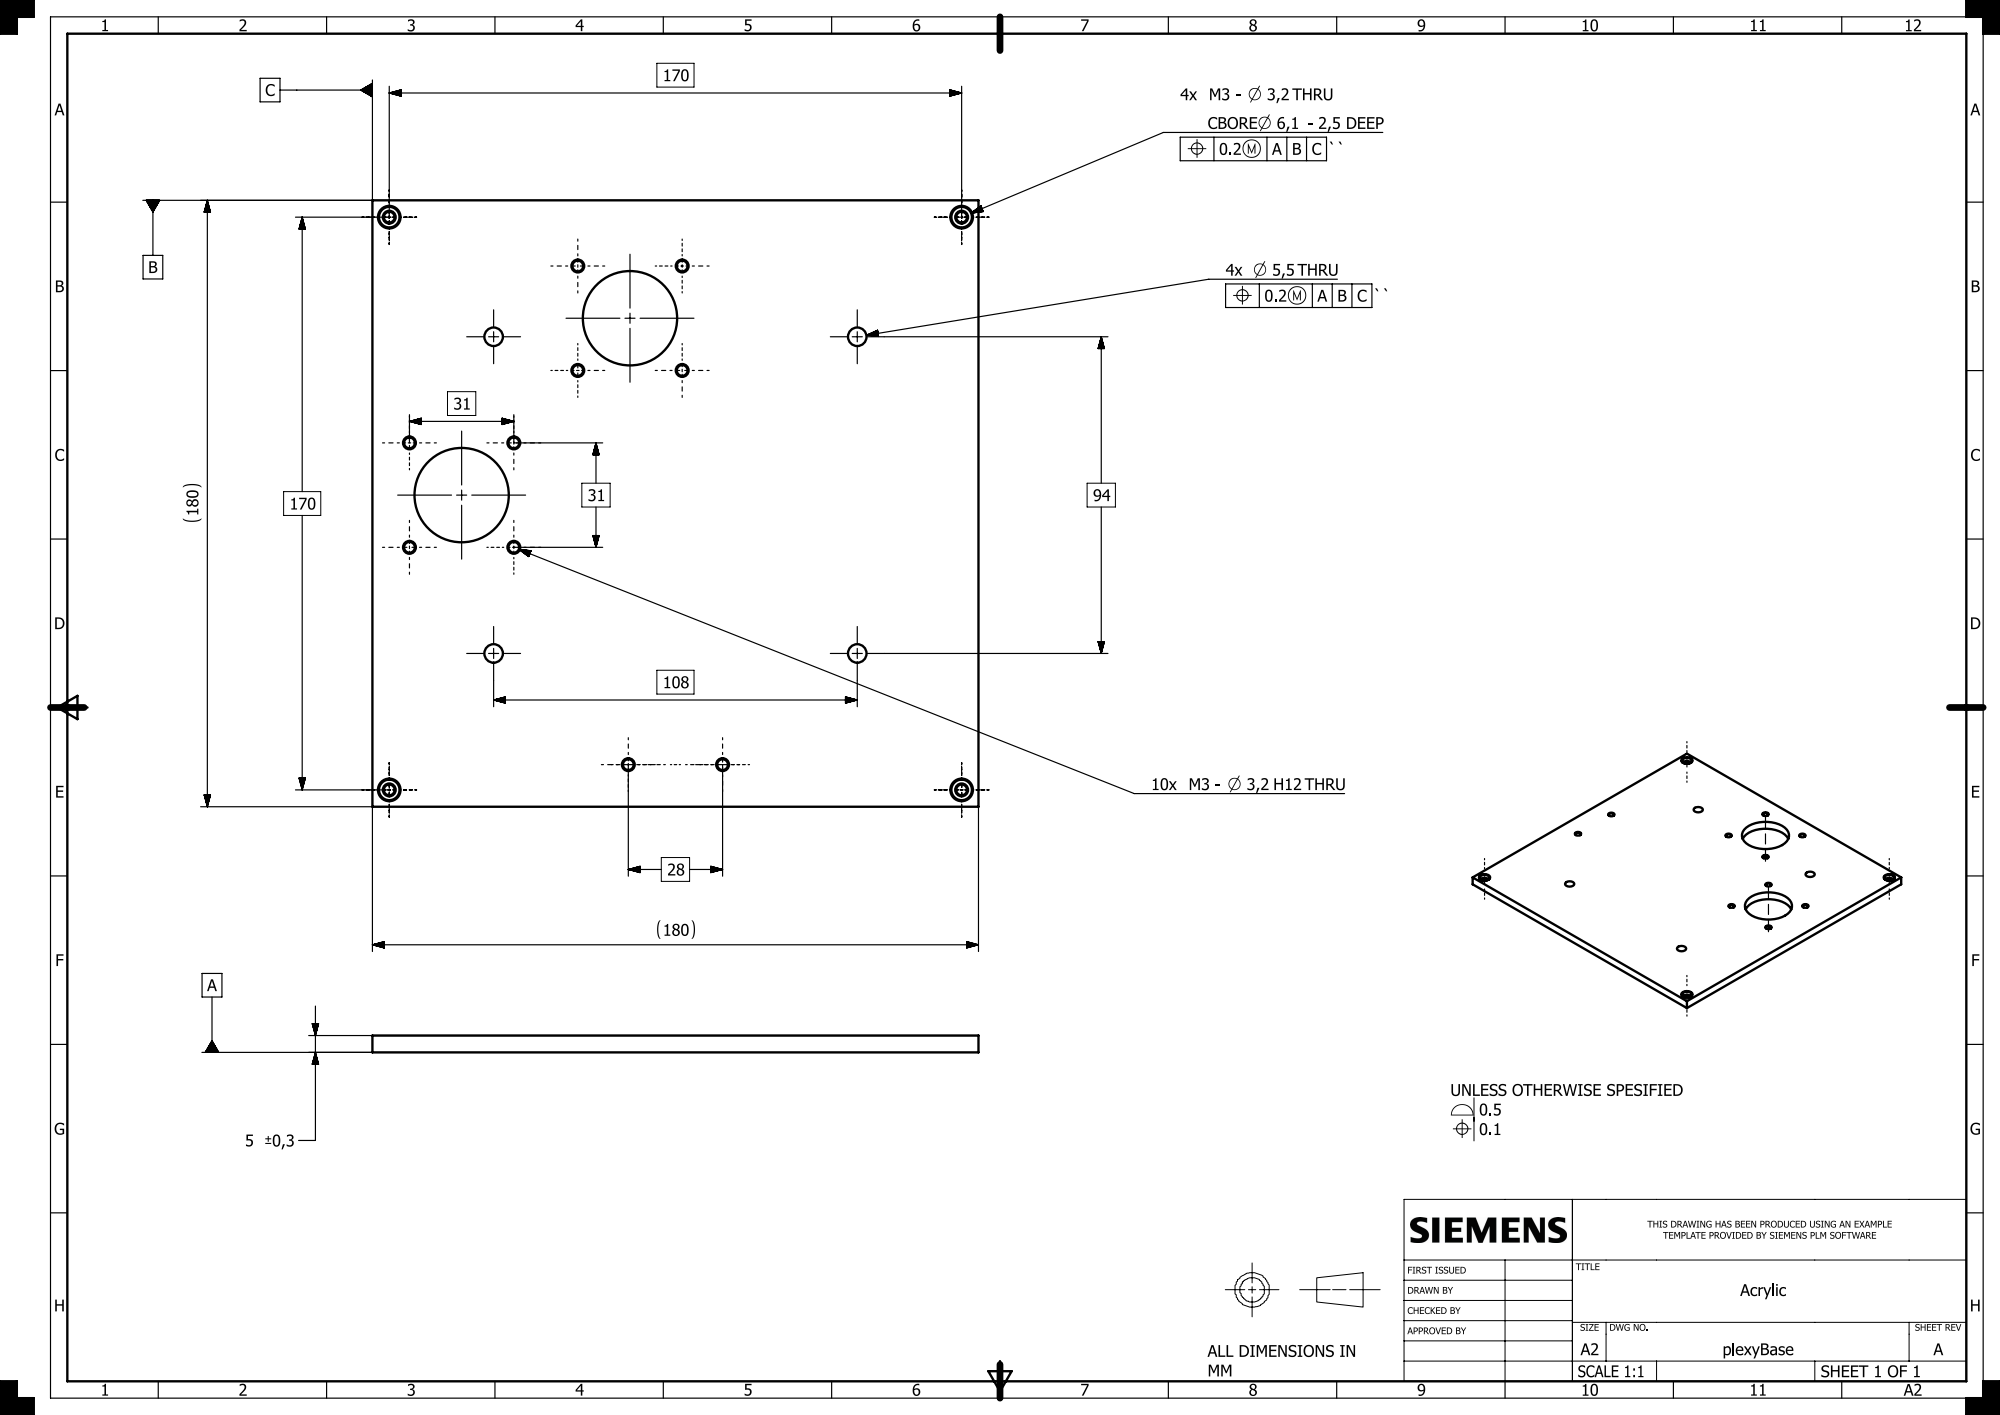
[picture p39: page 1]
