BARDAK1995/me407/hardware/drawings/mert_plexyBase_Alt.pdf

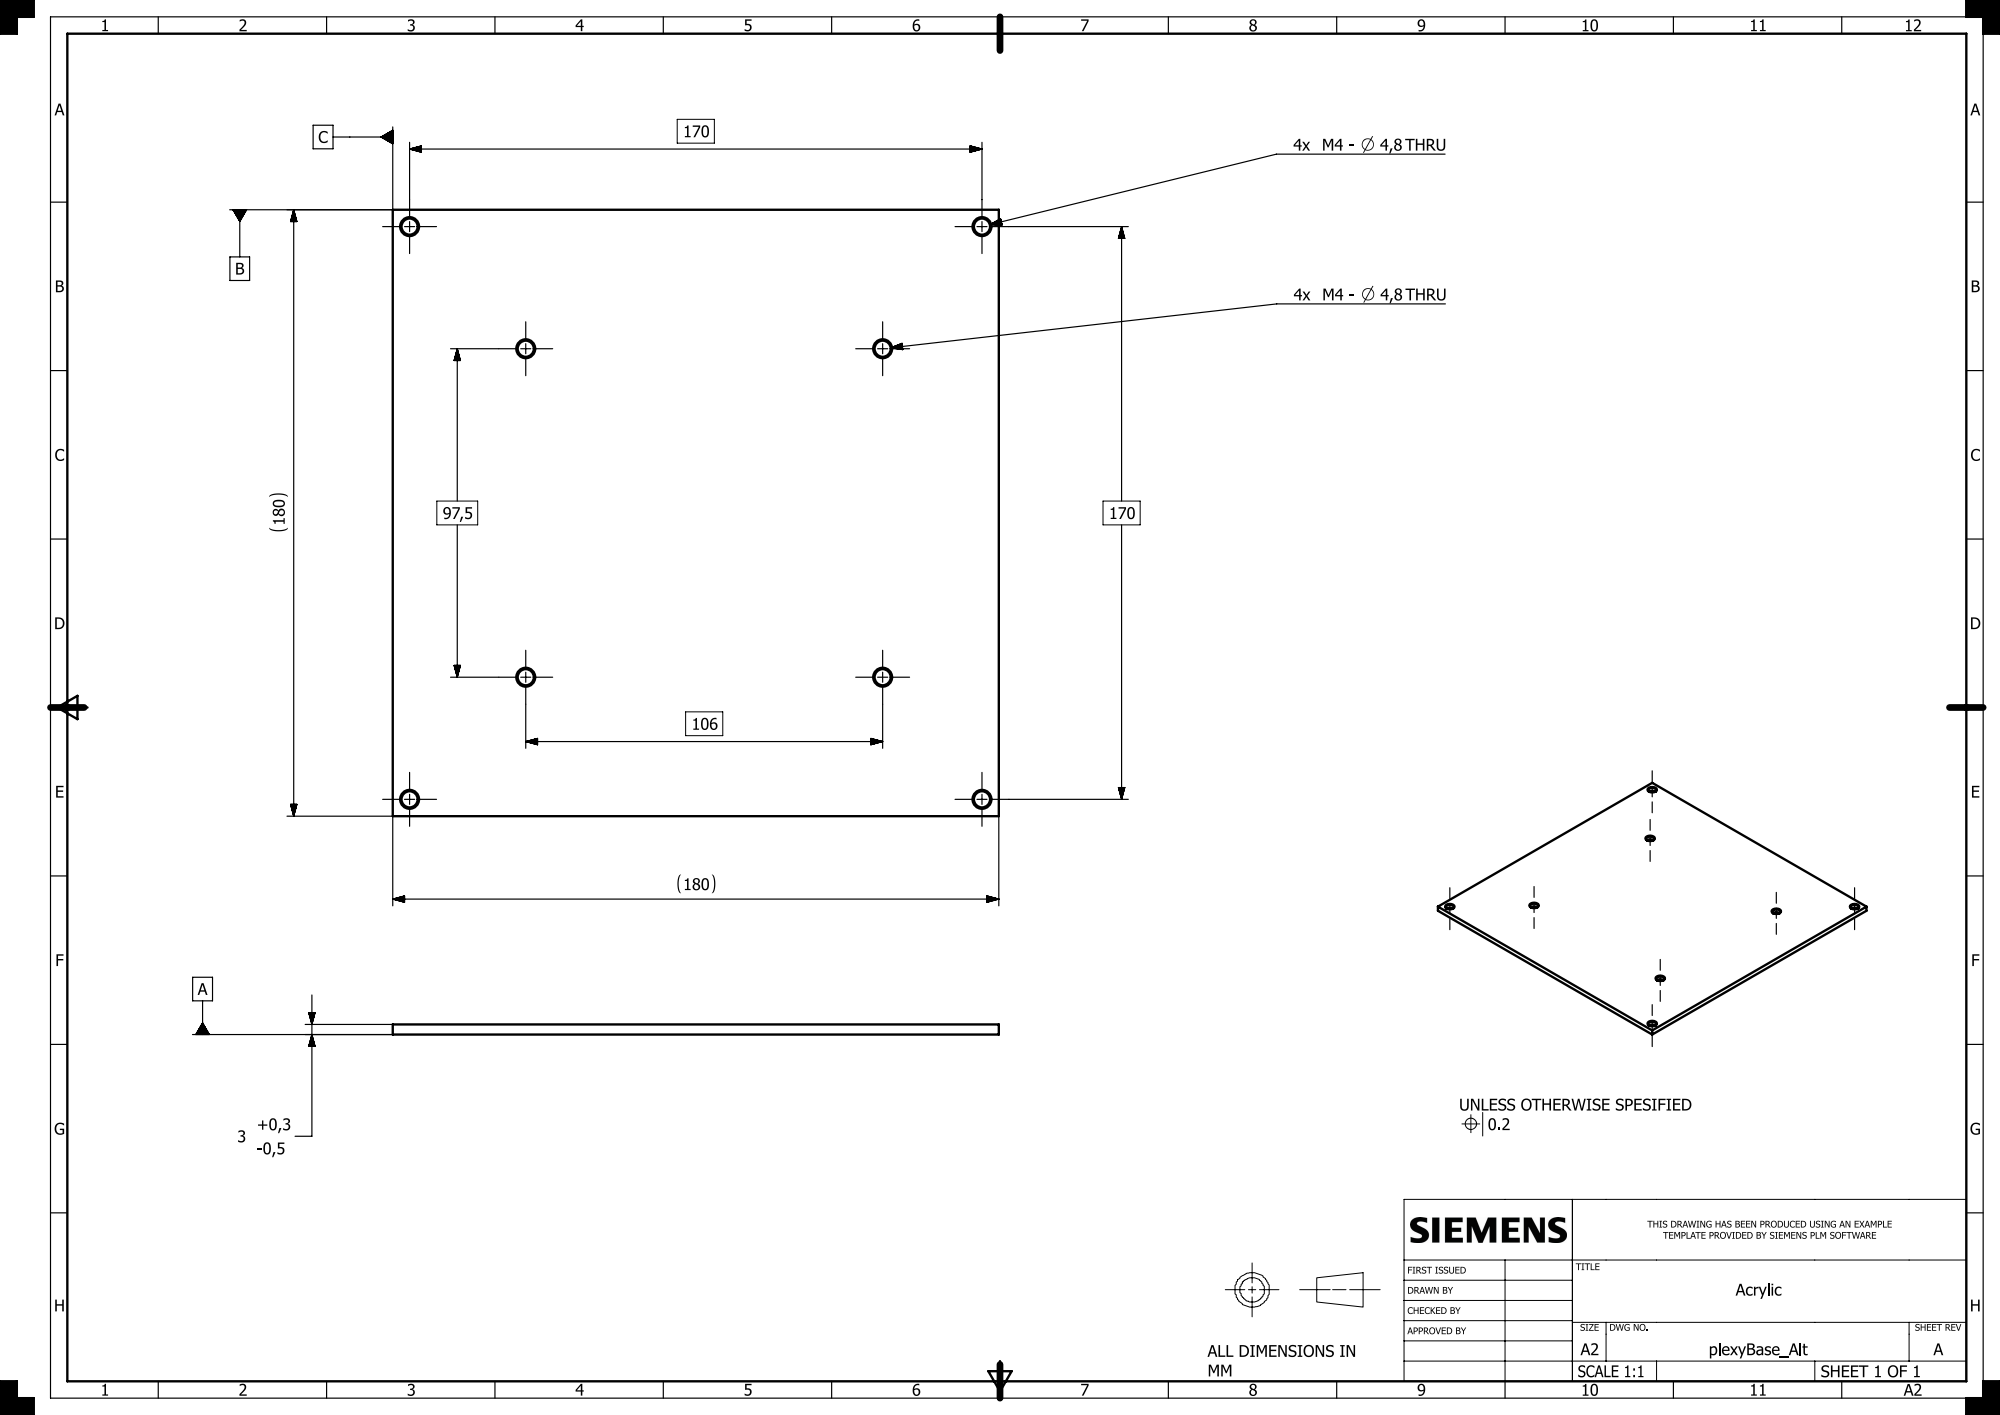
[picture p40: page 1]
