BARDAK1995/me407/hardware/drawings/mert_tabla.pdf

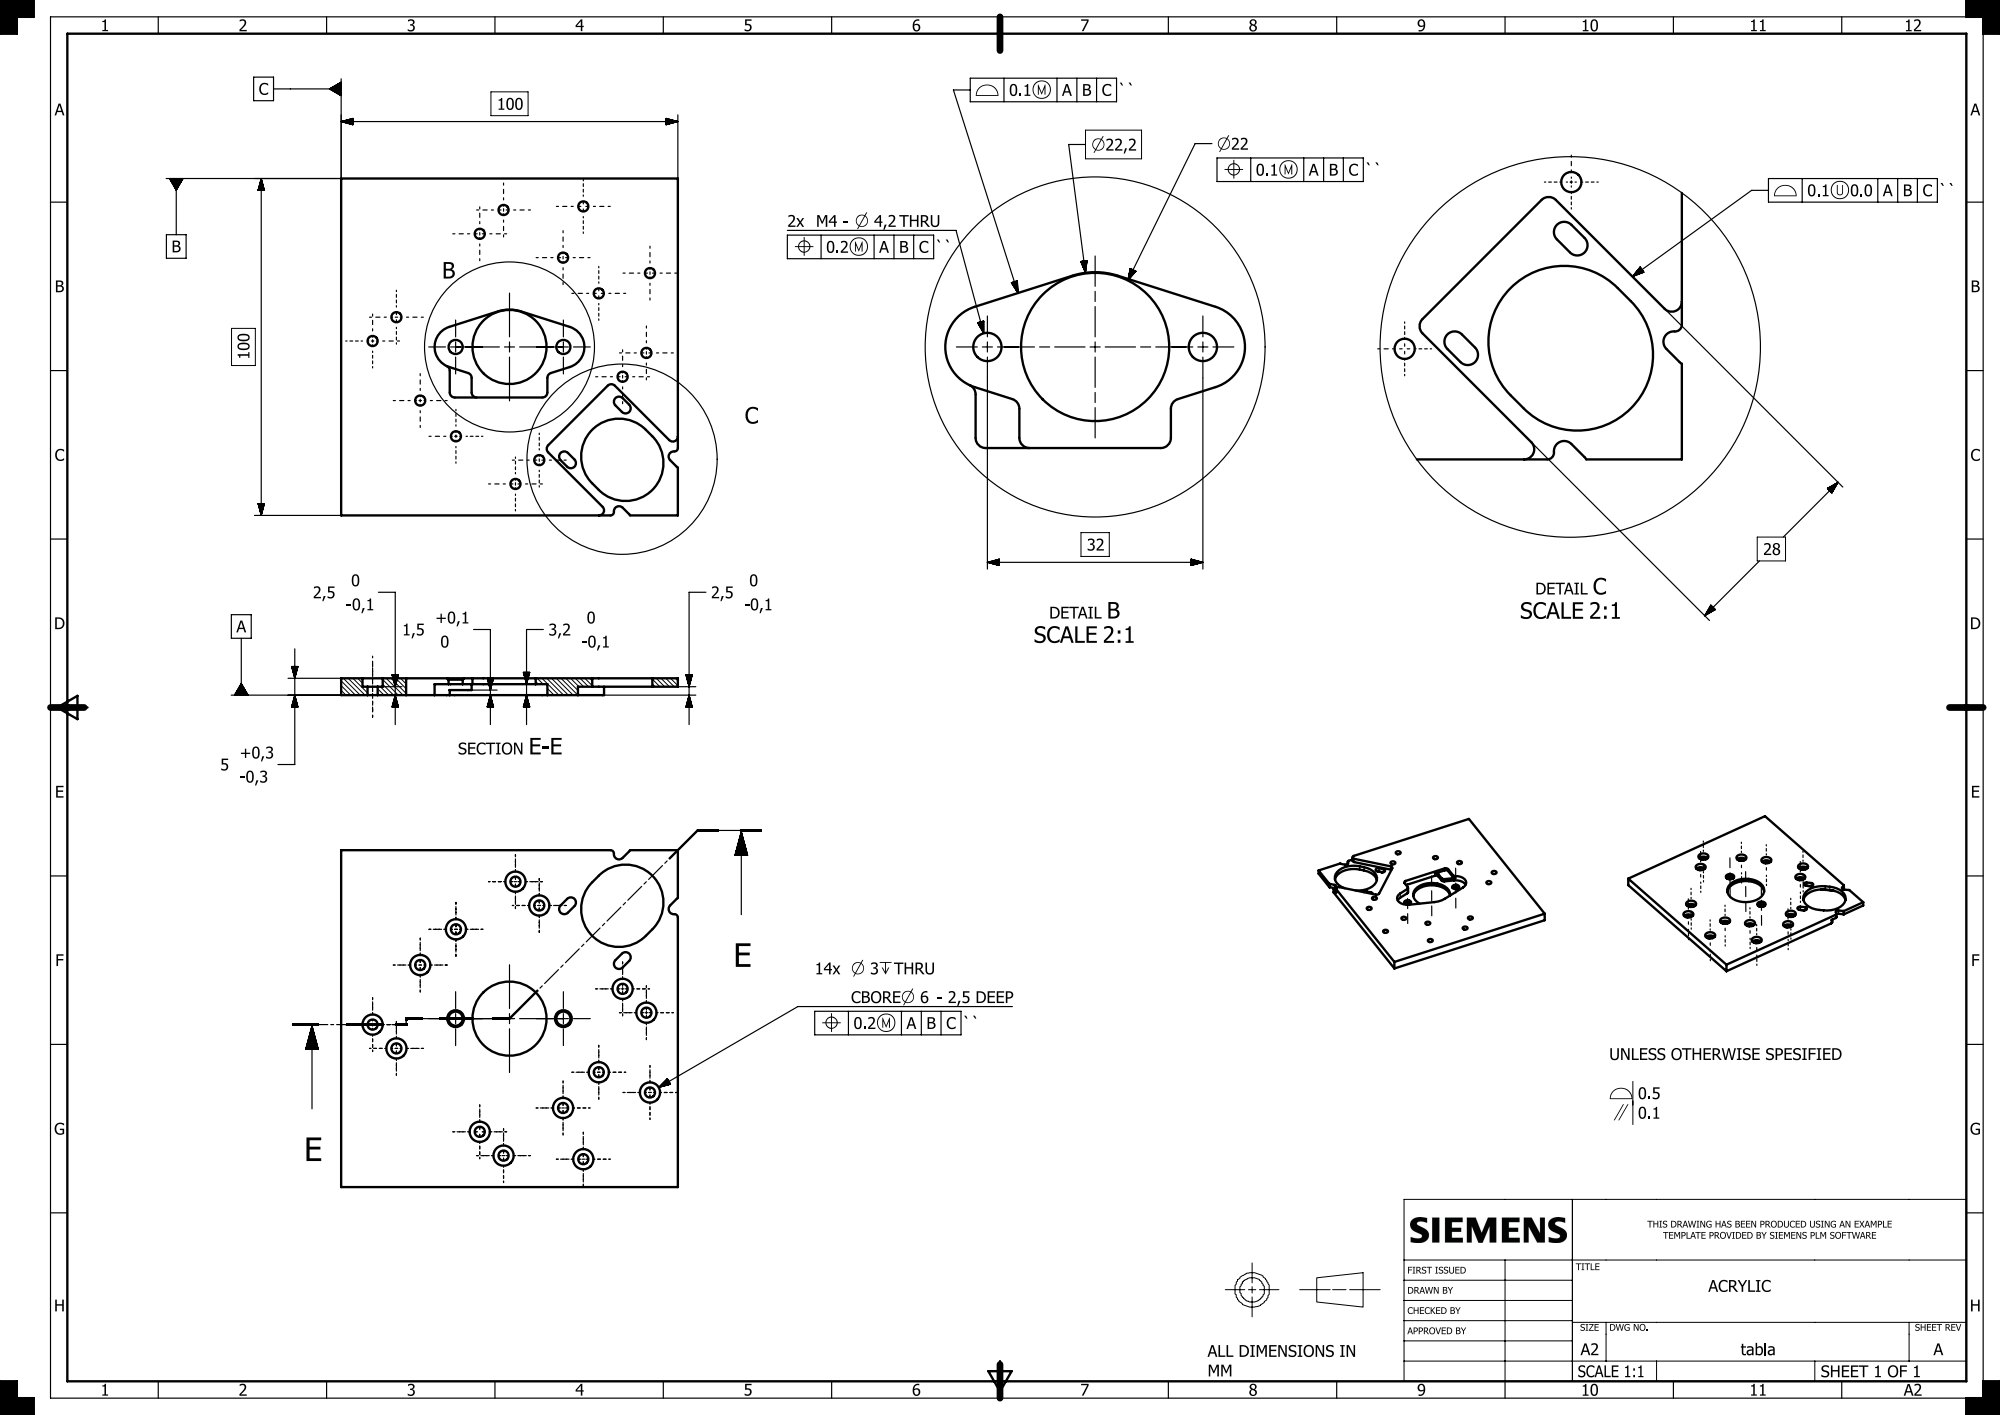
[picture p41: page 1]
