BARDAK1995/me407/radroTransmitter/radroTransmitter.ino

// Include RadioHead Amplitude Shift Keying Library
#include <RH_ASK.h>
// Include dependant SPI Library 
#include <SPI.h> 
 
// Create Amplitude Shift Keying Object
RH_ASK rf_driver;
 
void setup()
{
    // Initialize ASK Object
    rf_driver.init();
}
 
void loop()
{
    const char *msg = "Hello World";
    rf_driver.send((uint8_t *)msg, strlen(msg));
    rf_driver.waitPacketSent();
    delay(1000);
}
