BARDAK1995/me407/(commit log)

2026-10-28 Reorganise sketches into firmware/, firmware/dev/ and tools/
    Move the three device sketches (leveling controller, step-pulse generator,
    incline display) to firmware/, the development and test sketches to
    firmware/dev/, and the Processing viewer and timelapse script to tools/.
    History is kept (git mv). Remove UstEksenSurucu, which is byte-identical
    to steppperOLD, and three empty or stray files.
2026-10-28 Add the June 2020 firmware: final 2.4 GHz remote, receiver and controller versions
    These versions sat uncommitted in a local working copy after 2020-04-27.
    - firmware/: final leveling controller (2020-06-25), step-pulse generator
    (2020-06-04), incline display (2020-06-17), and the new nRF24L01 2.4 GHz
    yaw-stage receiver (2020-06-05) and handheld remote (2020-06-23).
    - firmware/dev/: the last 433 MHz remote pair (2020-05-25/26), the MPU6050
    calibration sketch (2020-06-17), the 2.4 GHz link tests, the Leonardo DMP
    logging sketch used for the drift tests, and the first stepper test.
2026-10-28 Add hardware: STEP models, drawings, CAM programs, BOM and cost sheet
    - hardware/step/: 33 STEP files from the 2020-05-25 manufacturing package
    (NX 11): own parts, plus the assembly files (MASTER_ASSEMBLY,
    topAssemblyprt, midFrame_SubASS, motorAssembly, DISPLAY_SUBBASS), which
    hold structure only. Vendor parts (steppers, drivers, modules, pulleys,
    lead screws, fasteners) are not included, so the assemblies open with
    those parts missing.
    - hardware/drawings/: six GD&T drawings (acrylic plates and shafts).
    - hardware/cam/: 46 NX CAM G-code programs for the acrylic plates and the
    wooden CNC fixture, including the dry runs cut in soap ("sabun").
    - hardware/BOM.xlsx and hardware/cost.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
2026-10-28 Add README, electronics notes, drift-test data and tools
    - README.md: what the device does, the layout, the five firmware roles,
    build notes, the drift tests, history, team and third-party credits.
    - docs/electronics.md: block diagram (Mermaid) and pin assignments for all
    five boards, rebuilt from the final sketches and the BOM, with photos of
    the breadboards and perfboards from the electronics deck.
    - tools/allan_deviation.py: the Allan-deviation script from May 2020.
    - data/drift_logs/: the zipped day and night MPU6050 logs (2020-05-12).
    - docs/figures/: the original Allan-deviation and static-roll plots and two
    NX renders. Photos are resized to 1600 px with EXIF metadata removed.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
